matyas1995/home-thermosthat/thermostat/README

Errata: gate resistors on GPIO LED drivers missing. Will not pose great problems as long as switching frequency does not get too high to overload MCU pins.
