matyas1995/home-thermosthat/frdm_board/FRDM-KW41Z_C2-DESIGNFILES/GRB-29102/ReadMe.txt

README for GRB-29102_C1.zip

Company Part Number: 170-29102 REV C1

Date: Fri, 13 Oct 2017 03:05:51 GMT

NXP Semiconductors
6501 William Cannon Drive West
Austin, TX 78735-8598

CAD Engineer
============
Company Contact     : [full_name]
Work Phone          : 512-895-XXXX
Email               : [email]@nxp.com

CAD Manager
===========
Company Contact     : Daniel Kruczek
Work Phone          : 512-895-6081
Email               : daniel.kruczek@nxp.com

Manufacturing Program Manager
=============================
Company Contact     : [full_name]
Work Phone          : 512-895-XXXX
Email               : [email]@nxp.com

Product Engineer
================
Company Contact     : [full_name]
Work Phone          : 512-895-XXXX
Email               : [email]@nxp.com

Design for Manufacturing Engineer
=================================
Company Contact     : Andres Marquez
Work Phone          : +52(33) 3283-2100 x3068
Email               : andres.marquez@nxp.com
