matyas1995/home-thermosthat/tempsensor/Mouser_BOM.xls

Mfr Part Number (Input) | Manufacturer Part Number | Mouser Part Number | Manufacturer Name | Description | Quantity 1 | Unit Price 1 | Quantity 2 | Unit Price 2 | Quantity 3 | Unit Price 3 | Quantity 4 | Unit Price 4 | Quantity 5 | Unit Price 5 | Order Quantity | Order Unit Price | Min./Mult. | Availability | Lead Time in Days | Lifecycle | NCNR | RoHS | Pb Free | Package Type | Datasheet URL | Product Image | Design Risk
 | 04025A100JAT2A | 581-04025A100J | AVX | CAP CER 10PF 50V 5% C0G 0402 | 2
 | GRM155R71H104KE14D | GRM155R71H104KE14D | MURATA | CAP CER 0.1uF 50V 10% X7R 0402 | 10
 | EMK107BBJ106MA-T | 963-EMK107BBJ106MA-T | TAIO YUDEN | CAP CER 10uF 16V 20% X5R 0603 | 3
 | CC0402BRNPO9BNR70 | 603-CC402BRNPO9BNR70 | YAGEO | CAP CER 0.7pF 50V 0.1pF C0G 0402 | 1
 | GRM155R61E105KA12 | 81-GRM155R61E105KA2 | MURATA | CAP CER 1uF 25V 10% X5R 0402 | 5
 | 04023C103KAT2A | 581-04023C103KAT2A | AVX | CAP CER 0,01uF 50V 10% X7R 0402 | 2
 | GCM1555C1H120JA16 | 81-GCM1555C1H120JA6 | MURATA | CAP CER 12PF 50V 5% C0G 0402 | 2
 | M50-3600542R | 855-M50-3600542R | HARWIN | Cortex Debug Connector, standard ARM Cortex-M SWD and JTAG interface | 1
 | ANT-2.4-LCW-RPS | 712-ANT-2.4-LCW-RPS | LINX |  | 1
 | 63012242124506 | 710-63012242124506 | WUERTH | coaxial connector (BNC, SMA, SMB, SMC, Cinch/RCA, ...) | 1
 | VLS3012CX-100M-1 | 810-VLS3012CX-100M-1 | TDK | IND WW FER 10uH@1MHz 1.12A 20% 3012 | 1
 | LQP15MN5N6B02D | 81-LQP15MN5N6B02D | MURATA | IND -- 5.6nH@500MHz 140mA 1.78% 0402 | 1
 | LQW15ANR10J00D | 81-LQW15ANR10J00D | MURATA | IND -- 0.1uH@100MHZ 120MA 5% 0402 | 2
 | CRCW04021K80FKED | 71-CRCW0402-1.8K-E3 | VISHAY | Resistor | 1
 | MKW41Z512VHT4 | 841-MKW41Z512VHT4 | NXP | Kinetis KW41Z-2.4 GHz, Arm Cortex-M0+, 512kB Flash, 128kB SRAM, Multi Mode: Bluetooth LE and 802.15.4 Wireless Radio and generic FSK, LQFN-48 | 1
 | MCP9844T-BE/MNY | 579-MCP9844T-BE/MNY | MICROCHIP | ±1°C Accurate, 1.8V Digital Temperature Sensor, I²C, DFN-8 | 1
 | BQ24012DRCR | 595-BQ24012DRCR | TEXAS INSTRUMENTS | Single-Chip Li-Ion Charge Management IC, DFN-10 | 1
 | FA-128 32.0000MF20X-K3 | 732-FA128-32F20X-K3 | EPSON | Four pin crystal, GND on pins 2 and 4 | 1
 | FC-135 32.7680KA-AG | 732-FC135-32.76KAAG | EPSON | Two pin crystal | 1
