matyas1995/home-thermosthat/thermostat/Mouser_BOM.xls

Mfr Part Number (Input) | Manufacturer Part Number | Mouser Part Number | Manufacturer Name | Description | Quantity 1 | Unit Price 1 | Quantity 2 | Unit Price 2 | Quantity 3 | Unit Price 3 | Quantity 4 | Unit Price 4 | Quantity 5 | Unit Price 5 | Order Quantity | Order Unit Price | Min./Mult. | Availability | Lead Time in Days | Lifecycle | NCNR | RoHS | Pb Free | Package Type | Datasheet URL | Product Image | Design Risk
 | 3002 | 534-3002 | KEYSTONE | Coin Cell Holder, SMD | 1
 | GRM155R71H104KE14D | GRM155R71H104KE14D | MURATA | CAP CER 0.1uF 50V 10% X7R 0402 | 9
 | EMK107BBJ106MA-T | 963-EMK107BBJ106MA-T | TAIO YUDEN | CAP CER 10uF 16V 20% X5R 0603 | 7
 | GRM155R61E105KA12 | 81-GRM155R61E105KA2 | MURATA | CAP CER 1uF 25V 10% X5R 0402 | 9
 | 04025A100JAT2A | 581-04025A100J | AVX | CAP CER 10PF 50V 5% C0G 0402 | 2
 | GCM1555C1H120JA16 | 81-GCM1555C1H120JA6 | MURATA | CAP CER 12PF 50V 5% C0G 0402 | 2
 | CC0402BRNPO9BNR70 | 603-CC402BRNPO9BNR70 | YAGEO | CAP CER 0.7pF 50V 0.1pF C0G 0402 | 1
 | CL10C050BB8NNNC | 187-CL10C050BB8NNNC | SAMSUNG | CAP CER 5pF 50V 0.1pF C0G 0603 | 2
 | CC0603KRX5R8BB475 | 603-CC0603KRX58BB475 | YAGEO | CAP CER 4,7uF 25V 10% X5R 0603 | 1
 | 865080643008 | 710-865080643008 | WUERTH | CAP POL 22uF 50V 20% | 1
 | EEE-FN1C221XL | 667-EEE-FN1C221XL | PANASONIC | CAP POL 220uF 16V 20% | 1
 | 04023C103KAT2A | 581-04023C103KAT2A | AVX | CAP CER 0,01uF 50V 10% X7R 0402 | 8
 | 63012242124506 | 710-63012242124506 | WUERTH | coaxial connector (BNC, SMA, SMB, SMC, Cinch/RCA, ...) | 1
 | ANT-2.4-LCW-RPS | 712-ANT-2.4-LCW-RPS | LINX | coax antenna | 1
 | SFV24R-4STE1HLF | 649-SFV24R-4STE1HLF | AMPHENOL | Generic connector, single row, 01x24, script generated (kicad-library-utils/schlib/autogen/connector/) | 1
 | M50-3600542R | 855-M50-3600542R | HARWIN | Cortex Debug Connector, standard ARM Cortex-M SWD and JTAG interface | 1
 | 61032021121 | 710-61032021121 | WUERTH | Generic connector, single row, 01x20, script generated (kicad-library-utils/schlib/autogen/connector/) | 1
 | 61000421121 | 710-61000421121 | WUERTH | Generic connector, double row, 02x02, odd/even pin numbering scheme (row 1 odd numbers, row 2 even numbers), script generated (kicad-library-utils/schlib/autogen/connector/) | 1
 | LQW15ANR10J00D | 81-LQW15ANR10J00D | MURATA | IND -- 0.1uH@100MHZ 120MA 5% 0402 | 4
 | LQP15MN5N6B02D | 81-LQP15MN5N6B02D | MURATA | IND -- 5.6nH@500MHz 140mA 1.78% 0402 | 1
 | LBC3225T680KR | 963-LBC3225T680KR | TAIO YUDEN | Inductor | 1
 | 45334C | 580-45334C | MURATA | Inductor with iron core | 1
 | RL0603JR-070R47L | 603-RL0603JR070R47L | YAGEO | Resistor | 1
 | MKW41Z512VHT4 | 841-MKW41Z512VHT4 | NXP | Kinetis KW41Z-2.4 GHz, Arm Cortex-M0+, 512kB Flash, 128kB SRAM, Multi Mode: Bluetooth LE and 802.15.4 Wireless Radio and generic FSK, LQFN-48 | 1
 | MCP7940NT-I/MS | 579-MCP7940NT-I/MS | MICROCHIP | Real-Time Clock, I2C, Battery Backup, MSOP-8 | 1
 | MCP9844T-BE/MNY | 579-MCP9844T-BE/MNY | MICROCHIP | ±1°C Accurate, 1.8V Digital Temperature Sensor, I²C, DFN-8 | 1
 | LM2574HVM-5.0/NOPB | 926-LM2574HVM5.0NOPB | TEXAS INSTRUMENTS | 5V, 0.5A SIMPLE SWITCHER® Step-Down Voltage Regulator, SO-8 | 1
 | FA-128 32.0000MF20X-K3 | 732-FA128-32F20X-K3 | EPSON | Four pin crystal, GND on pins 2 and 4 | 1
 | FC-135 32.7680KA-AG | 732-FC135-32.76KAAG | EPSON | Two pin crystal | 2
