matyas1995/home-thermosthat/frdm_board/FRDM-KW41Z_C2-DESIGNFILES/BOM-29102_C2.xlsx

FRDM-KW41Z Revised: Monday, November 06, 2017
SCH-29102 PDF: SPF-29102 Revision: C2
Freescale Semiconductor
6501 William Cannon Drive West
Austin, TX 78735-8598
Bill Of Materials November 14,2018 11:08:09 | Page1
Item | Quantity | AgilePN | ASSY_OPT | Reference | Value | Description | ASSY_NOTE | Mfg Name | Mfg Part Number | PCB Footprint
______________________________________________
1 | 1 | 510-75678 |  | ANT1 | F_Antenna | PCB F ANTENNA, NO PART ORDER |  | NOT A PART | NOT A PART | f_antenna_dig528-2
2 | 1 | 801-76130 |  | BT500 | 3003 | HOLDER BATTERY 20MM DIA TH |  | Keystone Electronics | 3003 | batt_21x20mm
3 | 3 | 150-76334 |  | C1,C2,C9 | 1000pF | CAP CER 1000PF 50V 5% C0G 0402 |  | MURATA | GRM1555C1H102JA01D | CC0402_25
4 | 9 | 150-79092 |  | C3,C19,C25,C27,C28,C30,C43,C66,C75 | 10uF | CAP CER 10uF 16V 20% X5R 0603 |  | TAIYO YUDEN | EMK107BBJ106MA-T | CC0603_OV
5 | 1 | 150-79793 |  | C4 | 0.7pF | CAP CER 0.7pF 50V 0.1pF C0G 0402 |  | MURATA | GRM1555C1HR70BA01D | CC0402_25
6 | 26 | 150-79069 |  | C6,C11,C17,C18,C20,C21,C22,C24,C26,C31,C44,C57,C58,C59,C60,C61,C62,C63,C64,C65,C68,C69,C70,C74,C76,C79 | 0.1uF | CAP CER 0.1uF 50V 10% X7R 0402 |  | MURATA | GRM155R71H104KE14D | CC0402_25
7 | 2 | 150-75265 | DNP | C7,C72 | 10PF | CAP CER 10PF 50V 5% C0G 0402 |  | AVX | 04025A100JAT2A | CC0402_25
8 | 2 | 150-75265 |  | C8,C71 | 10PF | CAP CER 10PF 50V 5% C0G 0402 |  | AVX | 04025A100JAT2A | CC0402_25
9 | 2 | 150-75266 | DNP | C10,C15 | 22PF | CAP CER 22PF 50V 5% C0G 0402 |  | AVX | 04025A220JAT2A | CC0402_25
10 | 1 | 150-79735 | DNP | C12 | 0.7pF | CAP CER 0.7pF 50V 0.05pF C0G 0402 |  | NIC COMPONENTS CORP | NMC-Q0402NPO0R7A50TRPF | CC0402_25
11 | 1 | 150-75116 | DNP | C13 | 18PF | CAP CER 18PF 50V 5% C0G 0603 |  | YAGEO AMERICA | CC0603JRNPO9BN180 | CC0603_OV
12 | 2 | 150-75680 |  | C14,C77 | 12PF | CAP CER 12PF 50V 5% C0G 0402 |  | NIC COMPONENTS CORP | NMC0402NPO120J50TRPF | CC0402_25
13 | 4 | 150-79795 |  | C23,C29,C67,C78 | 1uF | CAP CER 1UF 50V 10% X5R 0603 |  | MURATA | GRM188R61H105KAALD | CC0603_OV
14 | 2 | 150-30297 |  | C32,C33 | 220PF | CAP CER 220PF 50V 5% C0G 0402 |  | KEMET | C0402C221J5GAC | CC0402_25
15 | 1 | 150-78463 |  | C41 | 4.7uF | CAP CER 4.7UF 6.3V 20% X5R 0402 |  | TDK | C1005X5R0J475M050BC | CC0402_25
16 | 2 | 150-75417 |  | C48,C56 | 2.2uF | CAP CER 2.2UF 16V 10% X5R 0603 |  | MURATA | GRM188R61C225KE15D | CC0603_OV
17 | 3 | 150-79069 | DNP | C49,C81,C82 | 0.1uF | CAP CER 0.1uF 50V 10% X7R 0402 |  | MURATA | GRM155R71H104KE14D | CC0402_25
18 | 4 | 150-79092 | DNP | C50,C51,C52,C53 | 10uF | CAP CER 10uF 16V 20% X5R 0603 |  | TAIYO YUDEN | EMK107BBJ106MA-T | CC0603_OV
19 | 1 | 150-80001 |  | C80 | 1uF | CAP CER 1uF 25V 10% X5R 0402 |  | MURATA | GRM155R61E105KA12 | CC0402_25
20 | 5 | 150-80053 |  | C83,C84,C85,C86,C87 | 3.0PF | CAP CER 3.0PF 50V 3.3% C0G 0402 |  | MURATA | GRM1555C1H3R0BA01D | CC0402_25
21 | 2 | 370-76693 |  | LED2,D2 | YEL-GRN | LED SUPER YEL/GRN SGL 25MA SMD 0603 |  | EVERLIGHT INTERNATIONAL CORPORATION | 19-213SYGC/S454/TR8 | LED_0603
22 | 8 | 480-79681 |  | D3,D4,D5,D6,D7,D8,D9,D10 | RB160M-30 | DIODE SCH 1A 30V SOD123 |  | ROHM | RB160M-30TR | pmdu_sod123
23 | 1 | 370-76645 | DNP | D11 | VSMB2948SL | LED IR RA 100mA 1.35V 940NM SMD |  | VISHAY INTERTECHNOLOGY | VSMB2948SL | led_ra_2p5x2p75_sm
24 | 2 | 210-81494 |  | J1,J3 | SKT_1X8 | CON 1X8 SKT TH 100MIL SP 343H AU 126L |  | LIANYI DIANZI | 218108S1411 | con_1x8_skt_2p54_th
25 | 1 | 210-81493 |  | J2 | SKT_1X10 | CON 1X10 SKT TH 100MIL SP 343H AU 126L |  | LIANYI DIANZI | 218110S1411 | con_skt1x10_th
26 | 1 | 210-81495 |  | J4 | SKT_1X6 | CON 1X6 SKT TH 100MIL SP 343H AU 126L |  | LIANYI DIANZI | 218106S1411 | con_skt1x6_th
27 | 1 | 211-79911 |  | J5 | SLE-100010072-F01 | CON 1 JACK SMA SKT 50 OHM SMT -- 418H AU |  | Dongguan Senling Industrial Co. Ltd | SLE-100010072-F01 | con5_sma_7sq_sm
28 | 1 | 211-78945 |  | J6 | USB_MICRO_AB | CON 5 USB_MICRO_AB_RECEPTACLE RA SKT SMT 0.65MM SP 122H AU |  | molex | 475900001 | con_microab_10f_25_sm_ra
29 | 7 | 210-81145 |  | J8,J19,J20,J21,J23,J34,J35 | HDR_1X2 | HDR 1X2 TH 100MIL SP 347H AU 118L |  | LIANYI DIANZI | 313102S1411 | hdr_1x2_2p54mm
30 | 2 | 210-81148 |  | J9,J11 | HDR 2X5 | HDR 2X5 TH 50MIL CTR 264H AU 91L |  | LIANYI DIANZI | 333210S1411 | hdr_2X5_6x3_1p27mm_th
31 | 10 | 210-75439 | DNP | J12,J13,J14,J22,J25,J28,J29,J30,J31,J37 | HDR 1X2 TH | HDR 1X2 TH 100MIL SP 339H AU 98L |  | SAMTEC | TSW-102-07-G-S | SH_HDR102_BOTTOM
32 | 2 | 210-81149 | DNP | J16,J17 | HDR 2X3 | HDR 2X3 TH 100MIL CTR 350H AU 118L |  | LIANYI DIANZI | 313206S1411 | hdr203_m20
33 | 2 | 210-75442 |  | J18,J24 | HDR_1X3 | HDR 1X3 TH 100MIL SP 330H AU 98L |  | SAMTEC | HTSW-103-07-S-S | HDR103
34 | 1 | 210-75442 | DNP | J26 | HDR_1X3 | HDR 1X3 TH 100MIL SP 330H AU 98L |  | SAMTEC | HTSW-103-07-S-S | HDR103
35 | 1 | 210-81149 |  | J36 | HDR 2X3 | HDR 2X3 TH 100MIL CTR 350H AU 118L |  | LIANYI DIANZI | 313206S1411 | hdr203_m20
36 | 2 | 210-81145 | DNP | J38,J39 | HDR_1X2 | HDR 1X2 TH 100MIL SP 347H AU 118L |  | LIANYI DIANZI | 313102S1411 | hdr_1x2_2p54mm
37 | 1 | 370-76692 |  | LED1 | RED | LED ULTRA BRIGHT RED SGL 25MA SMT 0603 |  | EVERLIGHT INTERNATIONAL CORPORATION | 19-213/R6C-AP1Q2B/3T | led_0603
38 | 1 | 370-76689 |  | LED3 | RED | LED RED CLEAR SGL 25MA SMT 0805 |  | EVERLIGHT INTERNATIONAL CORPORATION | 17-21SURC/S530-A2/TR8 | led_2p_0805
39 | 1 | 370-76567 |  | LED4 | CLV1A-FKB-CJ1M1F1BB7R4S3 | LED RED BL GRN SGL 50/25/25mA SMT |  | CREE, INC | CLV1A-FKB-CJ1M1F1BB7R4S3 | led4_3p4x3mm_smt
40 | 1 | 180-78707 |  | L1 | 5.6nH | IND -- 5.6nH@500MHz 140mA 1.78% 0402 |  | MURATA | LQP15MN5N6B02 | IND_0402
41 | 2 | 180-78474 |  | L2,L4 | 330 OHM@100MHZ | IND FER BEAD 330 OHM@100MHZ 1.2A 25% 0603 |  | MURATA | BLM18PG331SN1 | IND_0603
42 | 1 | 180-78215 |  | L3 | 10uH | IND WW FER 10uH@1MHz 0.99A 20% 4012 |  | TDK | VLS4012ET-100M | ind_vls4012e
43 | 2 | 180-78473 |  | L5,L6 | 0.1uH | IND -- 0.1uH@100MHZ 120MA 5% 0402 |  | MURATA | LQW15ANR10J00D | IND_0402
44 | 4 | 480-79704 |  | Q1,Q5,Q6,Q7 | BSH111BK | TRAN NMOS SW FET 55V 210mA SOT23 |  | NEXPERIA | BSH111BKR | SOT23_A
45 | 1 | 480-75173 | DNP | Q2 | MMBT3904LT1G | TRAN NPN GEN 200MA 40V SOT-23 |  | NEXPERIA | MMBT3904,215 | SOT23_A
46 | 1 | 470-80022 |  | RT2 | 10K | THERMISTOR 10K 1/10W 1% 0603 |  | MuRata | NCP18XH103F03RB | RC0603_OV
47 | 3 | 470-30454 |  | R1,R2,R6 | 100 | RES MF 100 OHM 1/16W 1% 0402 |  | THYE MING TECH CO LTD | CR-02FL6--100R | RC0402_25
48 | 13 | 470-75394 | DNP | R3,R7,R12,R14,R32,R51,R73,R75,R92,R96,R676,R677,R678 | 0 | RES MF ZERO OHM 1/16W 5% 0402 |  | ROHM | MCR01MZPJ000 | RC0402_25
49 | 2 | 470-81149 |  | R8,R9 | 4.99K | RES MF 4.99K 1/16W 1% 0402 |  | YAGEO AMERICA | RC0402FR-074K99L | RC0402_25
50 | 3 | 470-30297 |  | R10,R57,R81 | 220 | RES MF 220 OHM 1/10W 5% 0603 |  | YAGEO AMERICA | RC0603JR-07220RL | RC0603_OV
51 | 17 | 470-80452 |  | R11,R13,R15,R20,R23,R33,R34,R38,R47,R60,R63,R65,R93,R652,R653,R654,R675 | 10K | RES MF 10K 1/16W 1% 0402 |  | yageo | RC0402FR-1310KL | RC0402_25
52 | 8 | 470-80452 | DNP | R16,R17,R24,R26,R40,R69,R70,R95 | 10K | RES MF 10K 1/16W 1% 0402 |  | yageo | RC0402FR-1310KL | RC0402_25
53 | 21 | 470-75394 |  | R18,R22,R29,R30,R31,R35,R37,R39,R42,R61,R66,R74,R77,R79,R80,R82,R83,R84,R86,R89,R97 | 0 | RES MF ZERO OHM 1/16W 5% 0402 |  | ROHM | MCR01MZPJ000 | RC0402_25
54 | 5 | 470-75626 |  | R19,R46,R59,R64,R91 | 4.7K | RES MF 4.7K 1/16W 5% 0402 |  | NIC COMPONENTS CORP | NRCL04J472TRF | RC0402_25
55 | 2 | 470-75790 |  | R21,R25 | 33 | RES MF 33.0 OHM 1/16W 1% 0402 |  | THYE MING TECH CO LTD | CR-02FL6---33R | RC0402_25
56 | 3 | 470-75555 |  | R27,R28,R41 | 1K | RES MF 1.0K 1/16W 5% 0402 |  | VISHAY INTERTECHNOLOGY | CRCW04021K00JNED | RC0402_25
57 | 1 | 470-76066 |  | R44 | 15K | RES MF 15.0K 1/16W 1% 0402 |  | NIC COMPONENTS CORP | NRCL04F1502TRF | RC0402_25
58 | 4 | 470-80866 |  | R45,R54,R87,R88 | 0 | RES MF ZERO OHM 1/10W -- 0603 |  | BOURNS | CR0603J/000ELF | RC0603_OV
59 | 1 | 470-81193 |  | R52 | 18.2 | RES MF 18.2 OHM 1/8W 1% 0805 |  | YAGEO AMERICA | RC0805FR-0718R2L | RC0805_OV
60 | 1 | 470-76303 |  | R55 | 1.5K | RES MF 1.5K 1/16W 5% 0402 |  | VISHAY INTERTECHNOLOGY | CRCW04021K50JNED | RC0402_25
61 | 1 | 470-81164 |  | R56 | 27K | RES MF 27K 1/16W 1% 0402 |  | YAGEO AMERICA | RC0402FR-0727KL | RC0402_25
62 | 2 | 470-76602 |  | R62,R67 | 2.2K | RES MF 2.2K 1/16W 5% 0402 |  | YAGEO AMERICA | RC0402JR-072K2L | RC0402_25
63 | 1 | 470-81192 |  | R85 | 102K | RES MF 102K 1/16W 1% HF 0402 |  | YAGEO AMERICA | RC0402FR-07102KL | RC0402_25
64 | 1 | 470-81163 | DNP | R90 | 180K | RES MF 180K 1/16W 1% 0402 |  | YAGEO AMERICA | RC0402FR-07180KL | RC0402_25
65 | 1 | 470-75626 | DNP | R94 | 4.7K | RES MF 4.7K 1/16W 5% 0402 |  | NIC COMPONENTS CORP | NRCL04J472TRF | RC0402_25
66 | 2 | 470-30782 |  | R670,R671 | 270 | RES MF 270 OHM 1/10W 1% AEC-Q200 0402 |  | KOA SPEER | RK73H1ETTP2700F | RC0402_25
67 | 1 | 470-30801 |  | R672 | 430 | RES MF 430 OHM 1/10W 1% AEC-Q200 0402 |  | KOA SPEER | RK73H1ETTP4300F | RC0402_25
68 | 15 | 470-76449 |  | SH3,SH4,SH7,SH8,SH9,SH10,SH11,SH12,SH13,SH14,SH15,SH25,SH28,SH29,SH30 | 0 | ZERO OHM CUT TRACE 0402 PADS; NO PART TO ORDER |  | LAYOUT ELEMENT ONLY | LAYOUT ELEMENT ONLY | SH0402
69 | 3 | 470-80018 |  | SH500,SH501,SH503 | 0 | ZERO OHM CUT TRACE 0603 PADS; NO PART TO ORDER |  | LAYOUT ELEMENT ONLY | LAYOUT ELEMENT ONLY | SH0603
70 | 4 | 510-78063 |  | SW1,SW3,SW4,SW6 | KAN0444-0201E1 | SW SPST TACT PB 50MA 12V SMT |  | WENZHOU GANGYUAN ELECTRONICS CO., LTD. | KAN0444-0201E1 | sw2_tact_4x3_sm
71 | 2 | 510-77018 |  | SW2,SW5 | 3x3mm | CAPACITIVE SINGLE ELECTRODE 3X3MM SQUARED ROUNDED CORNERS (NOT A PART TO ORDER) |  | Freescale | Single Electrode 3MM x 3MM | electrode_sq_3mm
72 | 1 | 210-79450 |  | TP1 | TESTLOOP_BLACK | TEST POINT PC MULTI PURPOSE BLK TH |  | KEYSTONE ELECTRONICS | 5011 | tp_th_063
73 | 35 | 211-76642 |  | TP2,TP6,TP7,TP8,TP14,TP17,TP18,TP19,TP20,TP21,TP22,TP24,TP25,TP26,TP27,TP28,TP29,TP30,TP31,TP32,TP33,TP34,TP41,TP42,TP45,TP47,TP48,TP50,TP51,TP52,TP53,TP54,TP55,TP56,TP58 | TPAD_030 | TEST POINT PAD 30MIL DIA SMT, NO PART TO ORDER |  | NOTACOMPONENT | NOTACOMPONENT | TPAD_030
74 | 19 | 211-76643 |  | TP3,TP4,TP9,TP10,TP11,TP12,TP15,TP16,TP23,TP35,TP36,TP37,TP38,TP39,TP40,TP43,TP44,TP46,TP57 | TPAD_040 | TEST POINT PAD 40MIL DIA SMT, NO PART TO ORDER |  | NOTACOMPONENT | NOTACOMPONENT | TPAD_040
75 | 2 | 480-78091 | DNP | TVS1,TVS2 | PGB2010402KRHF | DIODE ESD SUPPRESSOR BIDIR -- 12V 0402 |  | LITTELFUSE | PGB2010402KRHF | diode_0402
76 | 1 | 344-02171 |  | U1 | MKW41Z512VHT4 | IC MCU XCVR 2.4GHZ 1.71-3.6V MAPLGA48 |  | NXP SEMICONDUCTORS | MKW41Z512VHT4 | maplga48_7x7_0p5mm
77 | 3 | 480-76179 |  | U2,U3,U6 | 0402ESDA-MLP | DIODE TVS BIDIR -- 30V 0402 |  | COOPER BUSSMANN | 0402ESDA-MLP1 | 0402_mlp
78 | 1 | 342-00652 |  | U4 | AT45DB041E | IC MEM DATA FLASH 4MBIT SPI 85MHZ 1.65-3.6V UDFN8 |  | Adesto Technologies Corporation, Inc | AT45DB041E-MHN-Y | dfn8_1p27_6x5mm_3p6x4p2
79 | 3 | 312-80758 |  | U5,U15,U16 | 74LVCH1T45 | IC XCVR 1BIT 3-STATE DUAL 1.2-5.5V XSON6 |  | NEXPERIA | 74LVCH1T45GM,132 | udfn6_1x1p5mm
80 | 1 | 344-01231 |  | U7 | MK20DX128VFM5 | IC MCU FLASH 128KB 50MHZ 1.71-3.6V QFN32 |  | FREESCALE SEMICONDUCTOR | MK20DX128VFM5 | QFN32_S142EP
81 | 1 | 312-80762 |  | U8 | 74LVC2T45GM,125 | IC XCVR DUAL SUPPLY 1.2 -5.5V XQFN8 |  | NEXPERIA | 74LVC2T45GM,125 | qfn8_1p6x1p6mm
82 | 1 | 312-80418 |  | U9 | FXOS8700CQ | IC ACCELEROMETER AND MAGNETOMETER SENSOR 3-AXIS 2.5V QFN16 |  | Freescale Semiconductor | FXOS8700CQ | QFN5X3_0P5_3X3
83 | 1 | 315-79199 |  | U10 | MIC2005-0.8YM6 | IC LIN SW PWR 0.8A 2.5-5.5V SOT23-6 |  | MICREL | MIC2005-0.8YM6 | SOT23-6_a
84 | 1 | 315-80556 |  | U11 | NLX2G14 | IC INV DUAL SCHMITT TRIGGER 1.65-5.5V UDFN6 |  | On Semiconductor | NLX2G14AMUTCG | udfn6_1p45x1_0p5mm
85 | 1 | 312-80039 |  | U17 | NCP1117ST33T3G | IC VREG LDO 1A 3.3V SOT223 |  | ON Semiconductor | NCP1117ST33T3G | sot223
86 | 1 | 312-80763 |  | U500 | NTSX2102GU8H | IC DUAL SUPPLY XCVR 50 MBPS 5.5V XQFN8 |  | NXP Semiconductors | NTSX2102GU8H | xqfn8_1p45x1p25mm
87 | 1 | 230-77664 |  | X1 | 8.00MHZ | XTAL 8.00MHZ RSN CERAMIC -- SMT |  | MURATA | CSTCE8M00G55-R0 | xtal3_3p35x1p45_sm
88 | 1 | 230-78107 |  | Y1 | 32MHZ | XTAL 32MHZ 10PPF 10PPM SMT |  | EPSON ELECTRONICS | Q22FA12800092 | xtal4_2p1x1p7mm_sm
89 | 1 | 230-78102 |  | Y2 | 32.768KHZ | XTAL 32.768KHZ 7PF 20PPM -- SMT |  | EPSON ELECTRONICS | FC-135 32.7680KA-AG3 | XTAL2-3p2x1p5-SM
