matyas1995/home-thermosthat/firmware/TODO.md

- OpenThread Task soll auf interruptgesteuert statt polling umgestellt werden. Hauptsächsich scheitert das an der UART receive Funktion, da der Teil, der den Interrupt bisher auslöst, selber auf diesen wartet. Der Task Loop hat der nötige Code schon drin, nur auskommentiert.
    - Das soll so erreicht werden, dass alles OpenThread spezifische inkl. der UART in dem OpenThread Prozess bleibt, auch die UART auslöse etc. Funktionen. In den IRQHandler der PIT, XVCR und UART muss der TaskNotifyGive rein, damit die den OpenThread Prozess wecken können.
- processTransmit() kann auch direkt ins UART IRQ, da dort die selbe Kondition eh geprüft wird.
- Create bash script to start JLinkExe (maybe it is useful)
- rewrite the linker script with the tutorial of memfault to clean up shit. Also fix the startup code to use C code instead of the unreadable assembly file.
- to support VLLS mode and be able to wake up without having to restart the mcu, look into the memory map and the SRAM map. The SRAM has sections that are not powered off during VLLS
- insert a stack canary word between stack and heap to detect stack or heap overflows. The checking can be done with FreeRTOS. Sadly the MCU has no MPU for this...
- for the ePaper driver, use the Raspberry Pi code. It is C and not C++ like in the Arduino exapmle.
    https://github.com/waveshare/e-Paper/tree/master/RaspberryPi_JetsonNano/c/lib
