matyas1995/home-thermosthat/frdm_board/FRDM-KW41Z_C2-DESIGNFILES/FAB-29102_C1.pdf

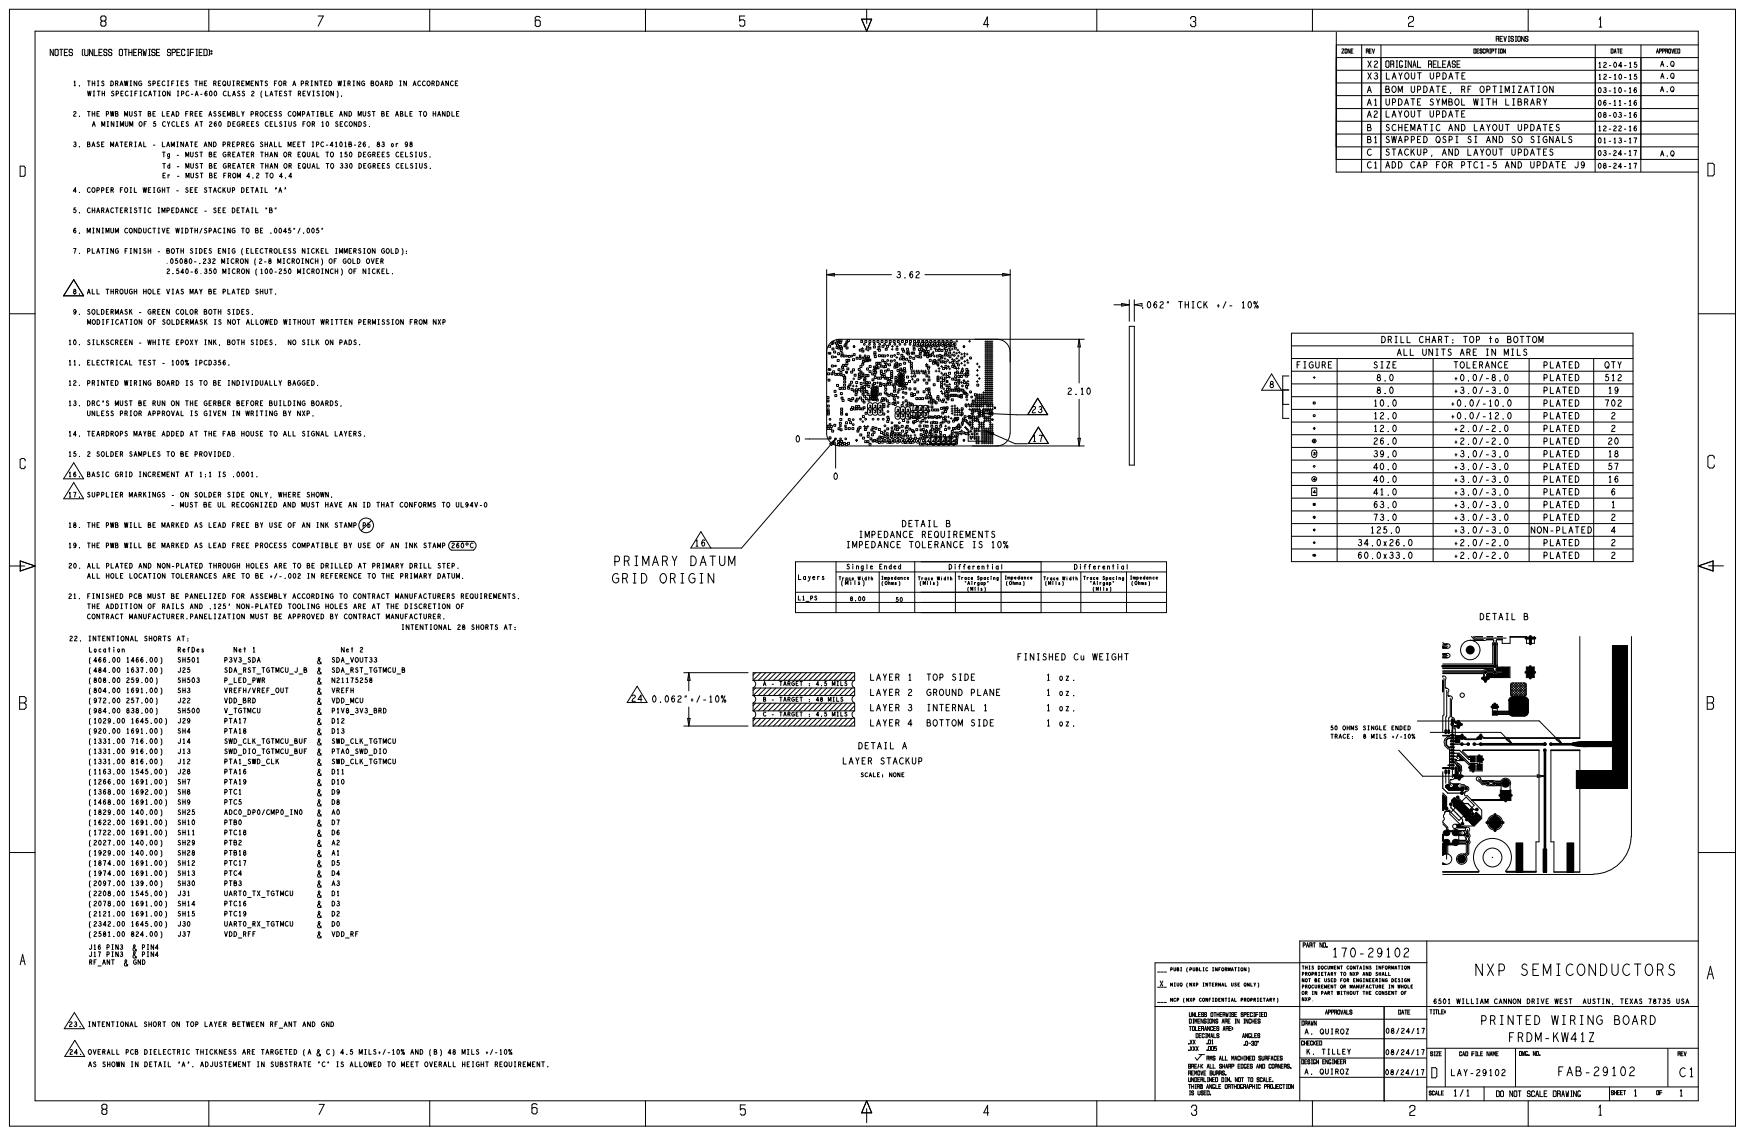
[picture p1: page 1]
