matyas1995/home-thermosthat/thermostat/home-thermostat.kicad_pcb

## KiCad design thermostat/home-thermostat.kicad_pcb (2021-06-10)

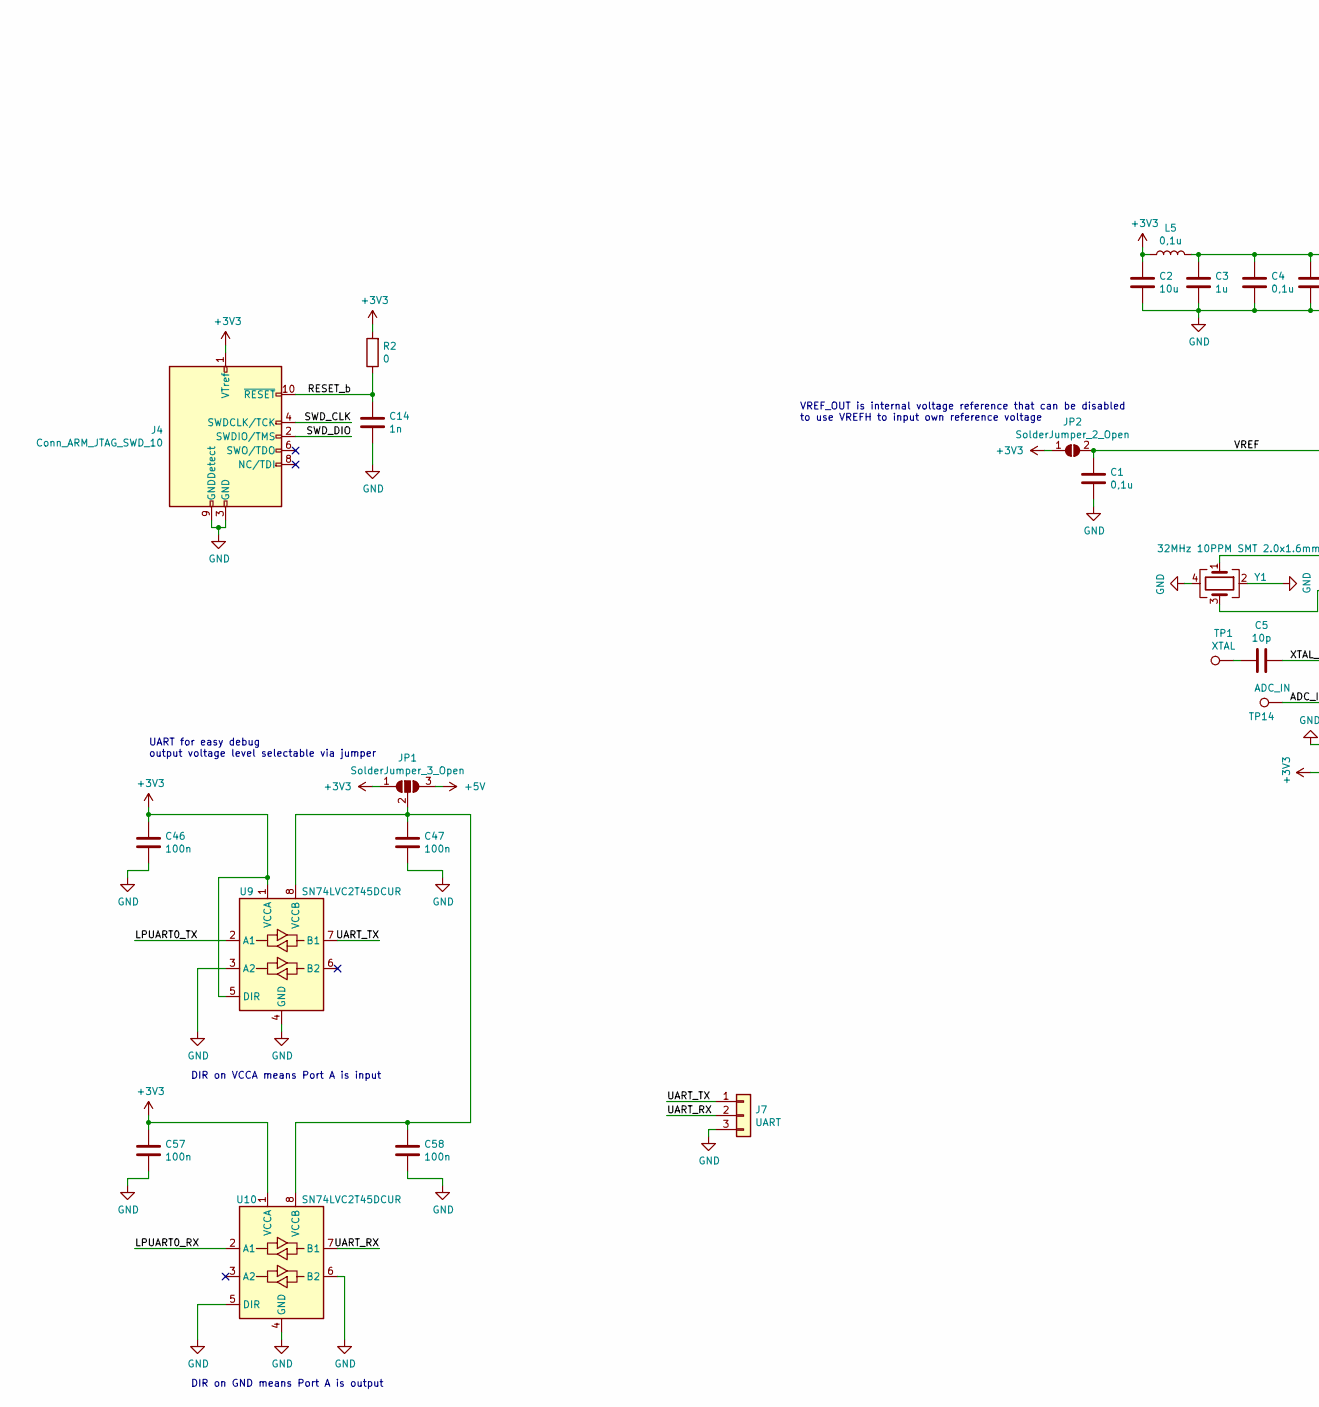
[picture p2: schematic home-thermostat.sch, part in row 1, column 1]

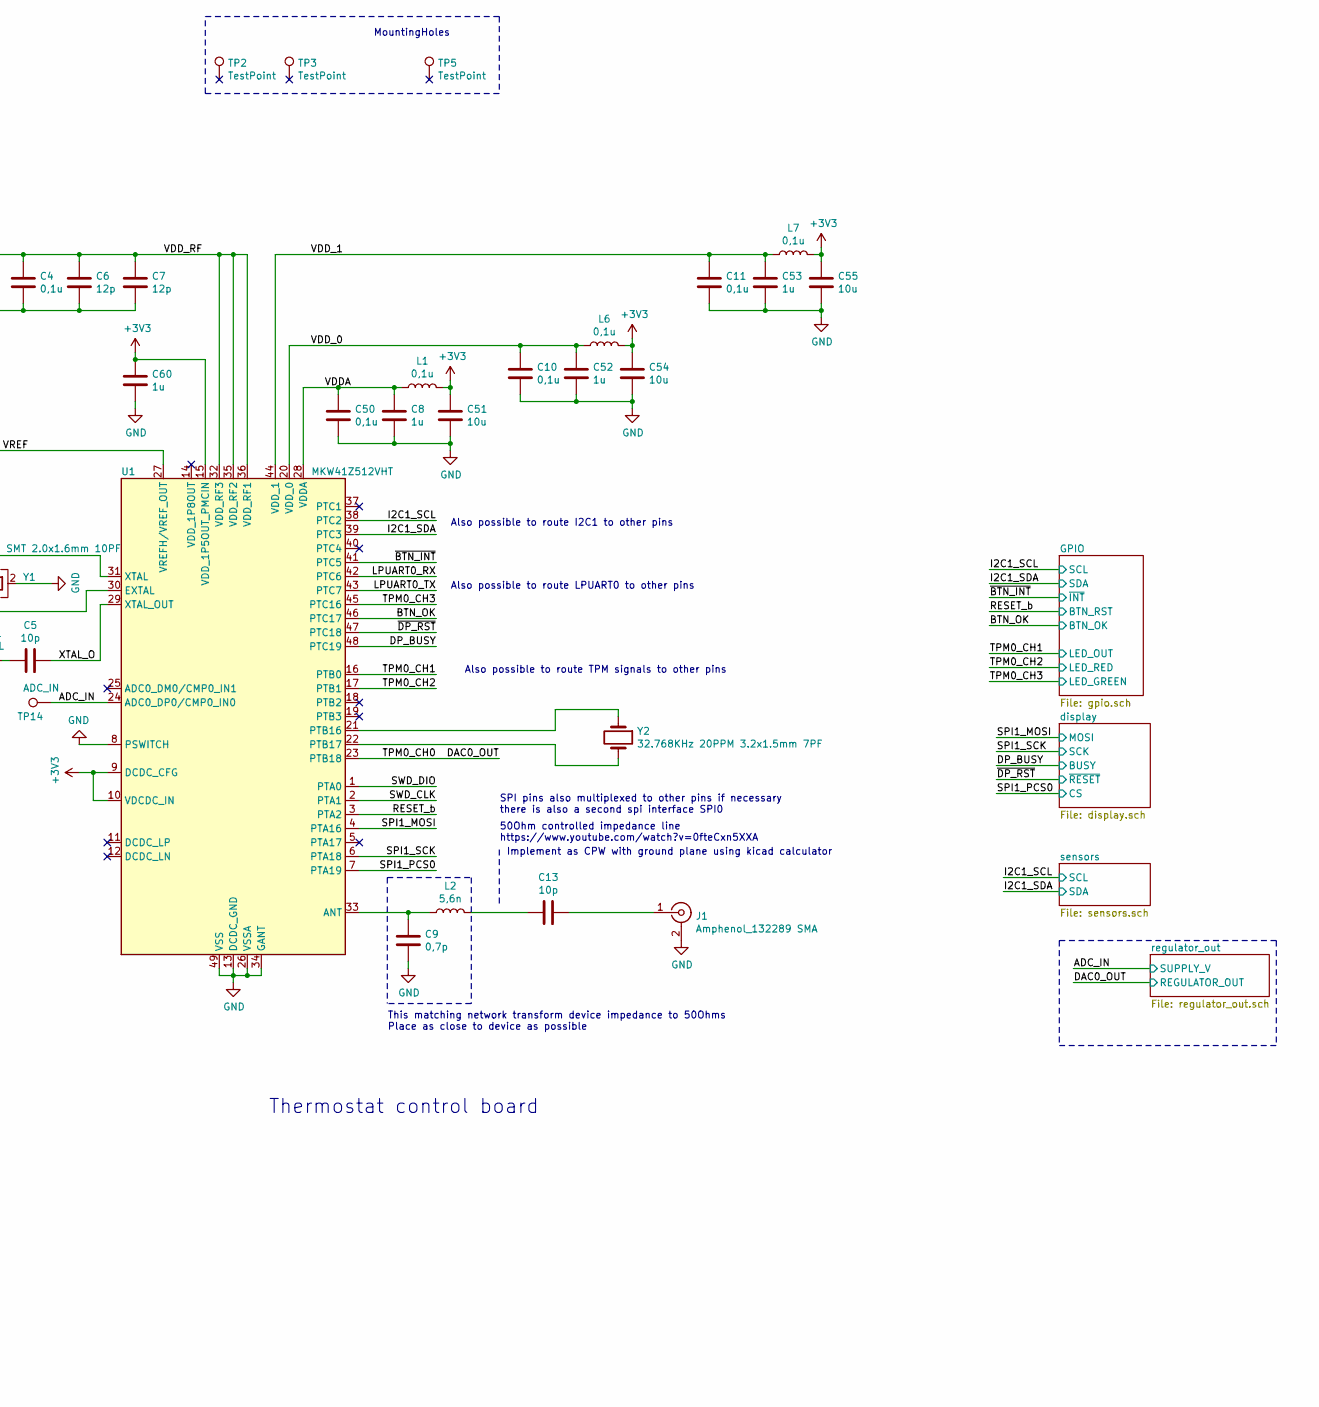
[picture p3: schematic home-thermostat.sch, part in row 1, column 2]

Parts:
C1, C4, C10, C11, C50: 0,1u; C_0402_1005Metric
C2, C51, C54, C55: 10u; C_0603_1608Metric
C3, C8, C52, C53, C60: 1u; C_0402_1005Metric
C5, C13: 10p; C_0402_1005Metric
C6, C7: 12p; C_0402_1005Metric
C9: 0,7p; C_0402_1005Metric
C14: 1n; C_0402_1005Metric
C46, C47, C57, C58: 100n; C_0603_1608Metric
J1: Amphenol_132289 SMA; SMA_Amphenol_132289_EdgeMount
J4: Conn_ARM_JTAG_SWD_10; PinHeader_2x05_P1.27mm_Vertical_SMD
J7: UART; PinHeader_1x03_P2.54mm_Vertical_SMD_Pin1Left
JP1: SolderJumper_3_Open; SolderJumper-3_P1.3mm_Open_Pad1.0x1.5mm
JP2: SolderJumper_2_Open; SolderJumper-2_P1.3mm_Open_Pad1.0x1.5mm
L1, L5, L6, L7: 0,1u; L_0402_1005Metric
L2: 5,6n; L_0402_1005Metric
R2: 0; R_0402_1005Metric
TP1: XTAL; TestPoint_Pad_D1.0mm
TP2, TP3, TP5: TestPoint; MountingHole_3.2mm_M3
TP14: ADC_IN; TestPoint_Pad_D1.0mm
U1: MKW41Z512VHT; NXP_LQFN-48-1EP_7x7mm_P0.5mm_EP3.5x3.5mm_16xMask0.45x0.45
U9, U10: SN74LVC2T45DCUR; VSSOP-8_3.0x3.0mm_P0.65mm
Y1: 32MHz 10PPM SMT 2.0x1.6mm 10PF; Crystal_SMD_2016-4Pin_2.0x1.6mm
Y2: 32.768KHz 20PPM 3.2x1.5mm 7PF; Crystal_SMD_3215-2Pin_3.2x1.5mm

Connections:
+3V3: C2.2, C46.1, C51.2, C54.2, C55.2, C57.1, C60.1, J4.1 (VTref), JP1.1 (A), JP2.1 (A), L1.2, L5.1, L6.2, L7.2, R2.2, U1.9 (DCDC_CFG), U1.10 (VDCDC_IN), U1.15 (VDD_1P5OUT_PMCIN), U9.1 (VCCA), U9.5 (DIR), U10.1 (VCCA); also elsewhere on the board
+5V: JP1.3 (B); also elsewhere on the board
/ADC_IN: TP14.1, U1.24 (ADC0_DP0/CMP0_IN0); also elsewhere on the board
/BTN_OK: U1.46 (PTC17); also elsewhere on the board
/DAC0_OUT: U1.23 (PTB18); also elsewhere on the board
/DP_BUSY: U1.48 (PTC19); also elsewhere on the board
/I2C1_SCL: U1.38 (PTC2); also elsewhere on the board
/I2C1_SDA: U1.39 (PTC3); also elsewhere on the board
/LPUART0_RX: U1.42 (PTC6), U10.2 (A1)
/LPUART0_TX: U1.43 (PTC7), U9.2 (A1)
/RESET_b: C14.1, J4.10 (~RESET~), R2.1, U1.3 (PTA2); also elsewhere on the board
/SPI1_MOSI: U1.4 (PTA16); also elsewhere on the board
/SPI1_PCS0: U1.7 (PTA19); also elsewhere on the board
/SPI1_SCK: U1.6 (PTA18); also elsewhere on the board
/SWD_CLK: J4.4 (SWDCLK/TCK), U1.2 (PTA1)
/SWD_DIO: J4.2 (SWDIO/TMS), U1.1 (PTA0)
/TPM0_CH1: U1.16 (PTB0); also elsewhere on the board
/TPM0_CH2: U1.17 (PTB1); also elsewhere on the board
/TPM0_CH3: U1.45 (PTC16); also elsewhere on the board
/UART_RX: J7.2, U10.7 (B1)
/UART_TX: J7.1, U9.7 (B1)
/VDDA: C8.1, C50.1, L1.1, U1.28 (VDDA)
/VDD_0: C10.1, C52.1, L6.1, U1.20 (VDD_0)
/VDD_1: C11.1, C53.1, L7.1, U1.44 (VDD_1)
/VDD_RF: C3.1, C4.1, C6.1, C7.1, L5.2, U1.32 (VDD_RF3), U1.35 (VDD_RF2), U1.36 (VDD_RF1)
/VREF: C1.1, JP2.2 (B), U1.27 (VREFH/VREF_OUT)
/XTAL_O: C5.1, U1.29 (XTAL_OUT)
/~BTN_INT: U1.41 (PTC5); also elsewhere on the board
/~DP_RST: U1.47 (PTC18); also elsewhere on the board
GND: C1.2, C2.1, C3.2, C4.2, C6.2, C7.2, C8.2, C9.2, C10.2, C11.2, C14.2, C46.2, C47.2, C50.2, C51.1, C52.2, C53.2, C54.1, C55.1, C57.2, C58.2, C60.2, J1.2 (Ext), J4.3 (GND), J4.5 (GND), J4.9 (GNDDetect), J7.3, U1.8 (PSWITCH), U1.13 (DCDC_GND), U1.26 (VSSA), U1.34 (GANT), U1.49 (VSS), U9.3 (A2), U9.4 (GND), U10.4 (GND), U10.5 (DIR), U10.6 (B2), Y1.2, Y1.4; also elsewhere on the board
unnamed: C5.2, TP1.1
unnamed: C9.1, L2.1, U1.33 (ANT)
unnamed: C13.1, J1.1 (In)
unnamed: C13.2, L2.2
unnamed: C47.1, C58.1, JP1.2 (C), U9.8 (VCCB), U10.8 (VCCB)
unnamed: U1.21 (PTB16), Y2.1
unnamed: U1.22 (PTB17), Y2.2
unnamed: U1.30 (EXTAL), Y1.3
unnamed: U1.31 (XTAL), Y1.1

Notes on the sheet:
Thermostat control board
50Ohm controlled impedance line https://www.youtube.com/watch?v=0fteCxn5XXA
Implement as CPW with ground plane using kicad calculator
This matching network transform device impedance to 50Ohms Place as close to device as possible
SPI pins also multiplexed to other pins if necessary there is also a second spi interface SPI0
Also possible to route I2C1 to other pins
Also possible to route LPUART0 to other pins
VREF_OUT is internal voltage reference that can be disabled to use VREFH to input own reference voltage
Also possible to route TPM signals to other pins
MountingHoles
DIR on VCCA means Port A is input
UART for easy debug output voltage level selectable via jumper
DIR on GND means Port A is output

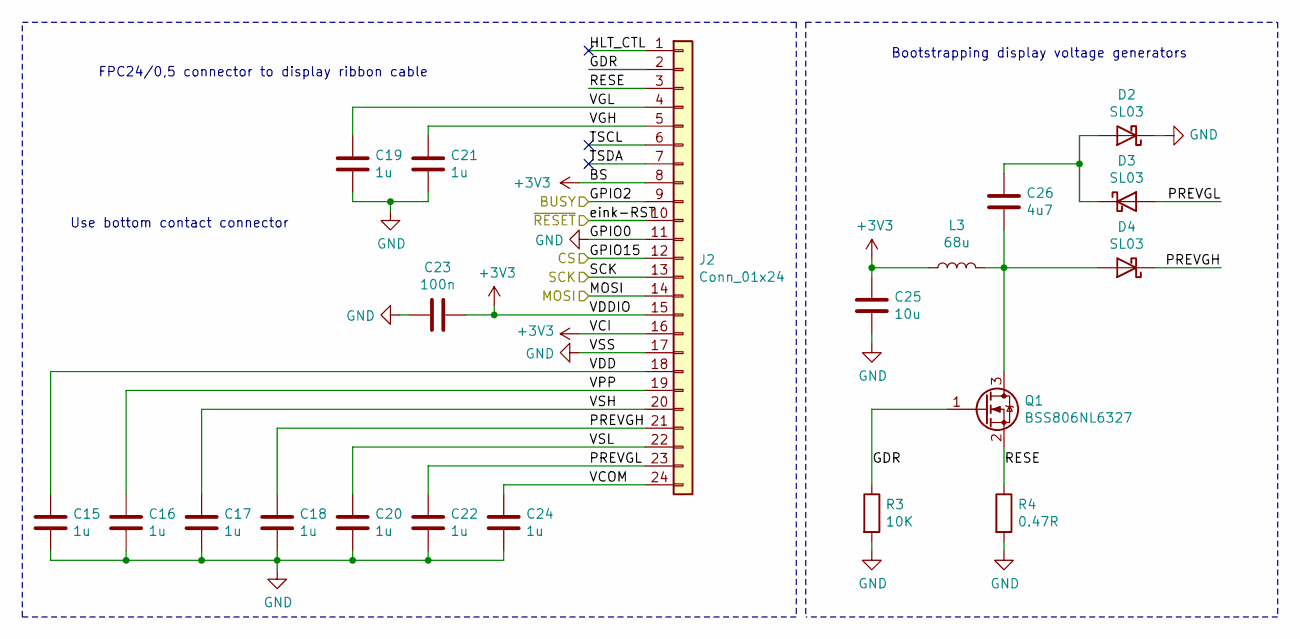
[picture p4: schematic display.sch]

Parts:
C15, C16, C17, C18, C19, C20, C21, C22, C24: 1u; C_0603_1608Metric
C23: 100n; C_0603_1608Metric
C25: 10u; C_0603_1608Metric
C26: 4u7; C_0603_1608Metric
D2, D3, D4: SL03; D_SMF
J2: Conn_01x24; TE_2-1734839-4_1x24-1MP_P0.5mm_Horizontal
L3: 68u; L_1210_3225Metric
Q1: BSS806NL6327; SOT-23
R3: 10K; R_0603_1608Metric
R4: 0.47R; R_0603_1608Metric

Connections:
+3V3: C23.2, C25.1, J2.8, J2.15, J2.16, L3.1; also elsewhere on the board
/DP_BUSY: J2.9; also elsewhere on the board
/SPI1_MOSI: J2.14; also elsewhere on the board
/SPI1_PCS0: J2.12; also elsewhere on the board
/SPI1_SCK: J2.13; also elsewhere on the board
/display/GDR: J2.2, Q1.1 (G), R3.1
/display/HLT_CTL: J2.1
/display/PREVGH: C18.1, D4.1 (K), J2.21
/display/PREVGL: C22.1, D3.2 (A), J2.23
/display/RESE: J2.3, Q1.2 (S), R4.1
/display/TSCL: J2.6
/display/TSDA: J2.7
/display/VCOM: C24.1, J2.24
/display/VDD: C15.1, J2.18
/display/VGH: C21.2, J2.5
/display/VGL: C19.2, J2.4
/display/VPP: C16.1, J2.19
/display/VSH: C17.1, J2.20
/display/VSL: C20.1, J2.22
/~DP_RST: J2.10; also elsewhere on the board
GND: C15.2, C16.2, C17.2, C18.2, C19.1, C20.2, C21.1, C22.2, C23.1, C24.2, C25.2, D2.1 (K), J2.11, J2.17, R3.2, R4.2; also elsewhere on the board
unnamed: C26.1, D2.2 (A), D3.1 (K)
unnamed: C26.2, D4.2 (A), L3.2, Q1.3 (D)

Notes on the sheet:
FPC24/0,5 connector to display ribbon cable
Bootstrapping display voltage generators
Use bottom contact connector

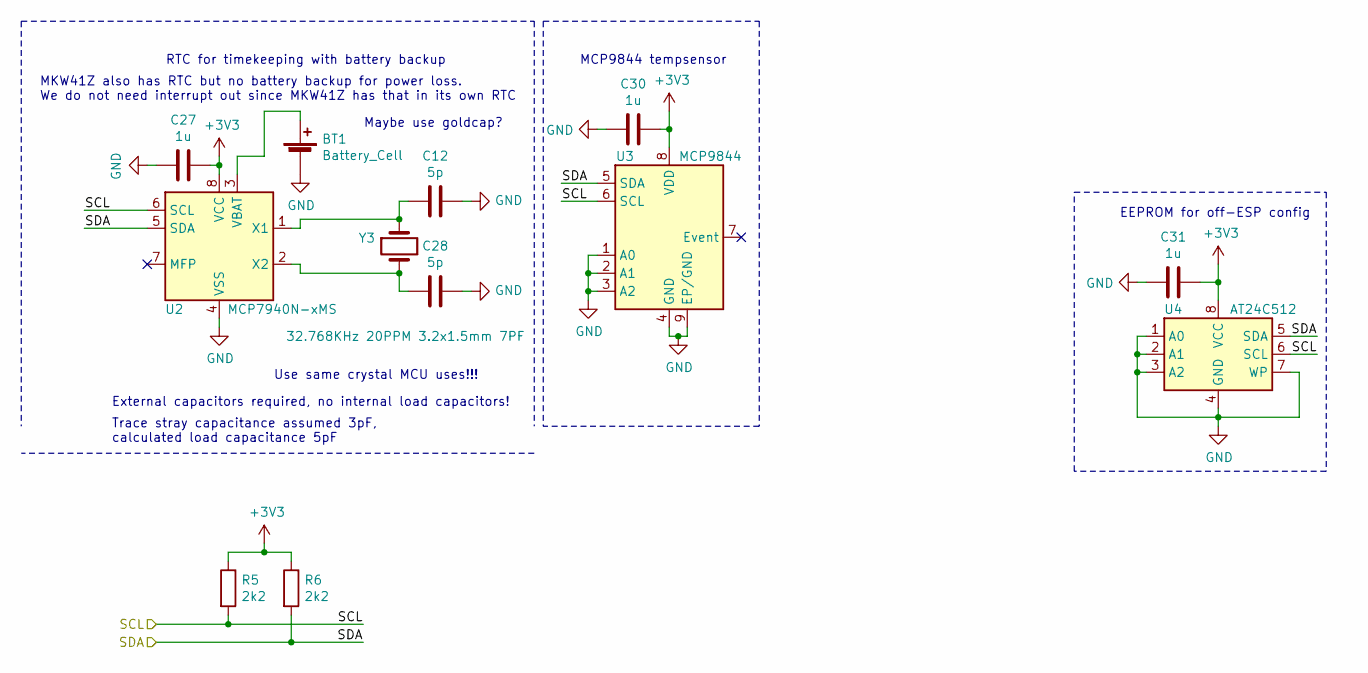
[picture p5: schematic sensors.sch]

Parts:
BT1: Battery_Cell; BatteryHolder_Keystone_3002_1x2032
C12, C28: 5p; C_0603_1608Metric
C27, C30, C31: 1u; C_0603_1608Metric
R5, R6: 2k2; R_0603_1608Metric
U2: MCP7940N-xMS; MSOP-8_3x3mm_P0.65mm
U3: MCP9844; DFN-8-1EP_3x2mm_P0.5mm_EP1.36x1.46mm
U4: AT24C512; DIP-8_W7.62mm_SMDSocket_SmallPads
Y3: 32.768KHz 20PPM 3.2x1.5mm 7PF; Crystal_SMD_3215-2Pin_3.2x1.5mm

Connections:
+3V3: C27.1, C30.1, C31.1, R5.1, R6.1, U2.8 (VCC), U3.8 (VDD), U4.8 (VCC); also elsewhere on the board
/I2C1_SCL: R5.2, U2.6 (SCL), U3.6 (SCL), U4.6 (SCL); also elsewhere on the board
/I2C1_SDA: R6.2, U2.5 (SDA), U3.5 (SDA), U4.5 (SDA); also elsewhere on the board
GND: BT1.2 (-), C12.1, C27.2, C28.1, C30.2, C31.2, U2.4 (VSS), U3.1 (A0), U3.2 (A1), U3.3 (A2), U3.4 (GND), U3.9 (EP/GND), U4.1 (A0), U4.2 (A1), U4.3 (A2), U4.4 (GND), U4.7 (WP); also elsewhere on the board
unnamed: BT1.1 (+), U2.3 (VBAT)
unnamed: C12.2, U2.1 (X1), Y3.1
unnamed: C28.2, U2.2 (X2), Y3.2

Notes on the sheet:
RTC for timekeeping with battery backup
Maybe use goldcap?
MCP9844 tempsensor
MKW41Z also has RTC but no battery backup for power loss. We do not need interrupt out since MKW41Z has that in its own RTC
EEPROM for off-ESP config
Use same crystal MCU uses!!!
External capacitors required, no internal load capacitors!
Trace stray capacitance assumed 3pF, calculated load capacitance 5pF

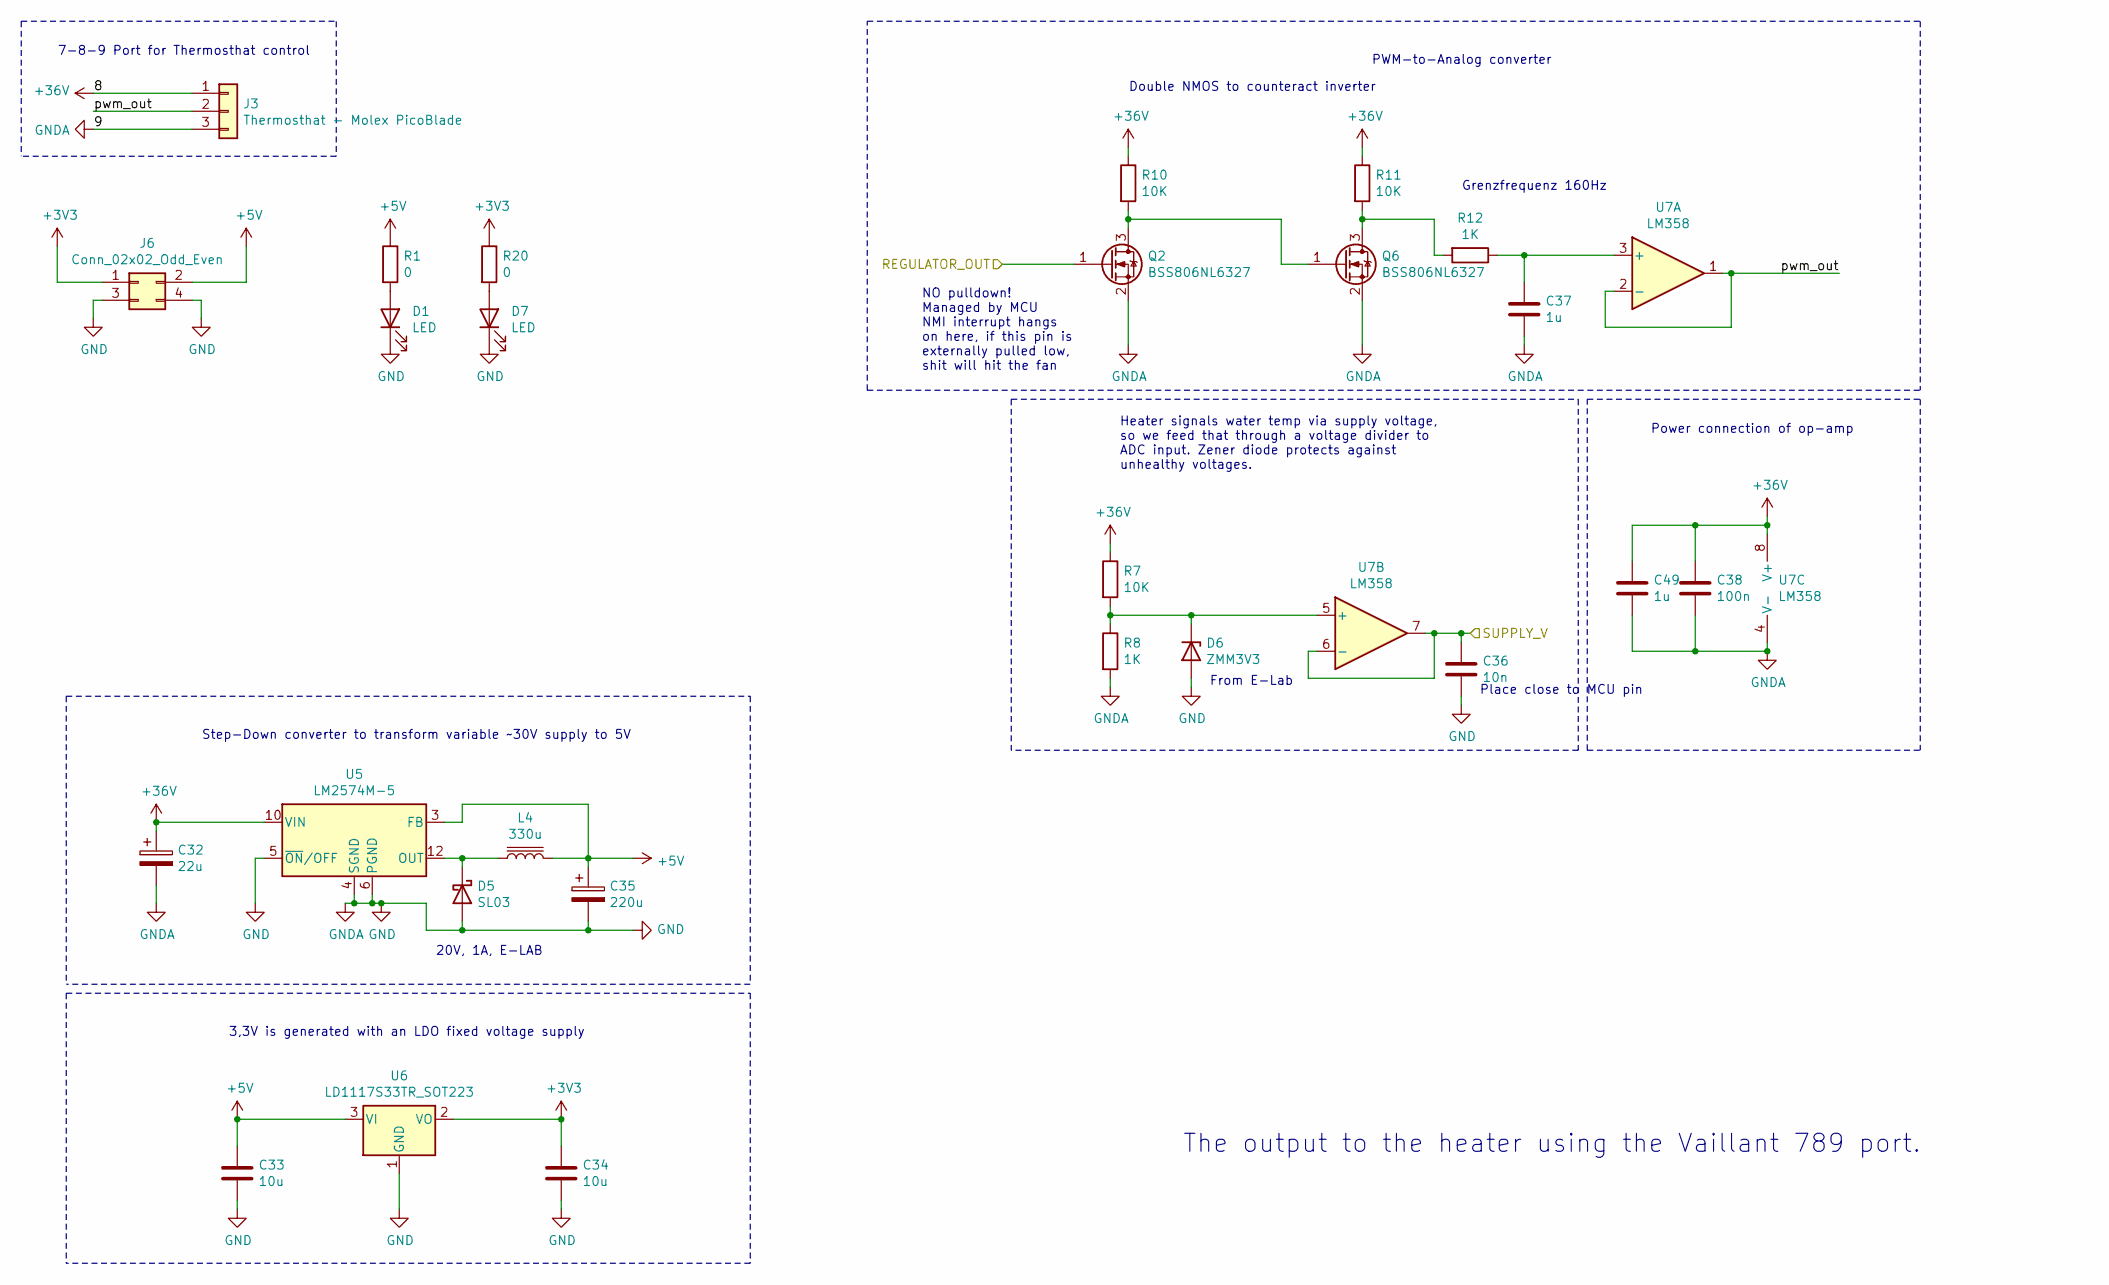
[picture p6: schematic regulator_out.sch]

Parts:
C32: 22u; CP_Elec_6.3x3
C33, C34: 10u; C_0603_1608Metric
C35: 220u; CP_Elec_6.3x5.4
C36: 10n; C_0402_1005Metric
C37, C49: 1u; C_0603_1608Metric
C38: 100n; C_0603_1608Metric
D1, D7: LED; LED_1210_3225Metric
D5: SL03; D_SMF
D6: ZMM3V3; D_MiniMELF
J3: Thermosthat - Molex PicoBlade; PinHeader_1x03_P2.54mm_Vertical_SMD_Pin1Left
J6: Conn_02x02_Odd_Even; PinHeader_2x02_P2.54mm_Vertical_SMD
L4: 330u; L_7.3x7.3_H3.5
Q2, Q6: BSS806NL6327; SOT-23
R1, R20: 0; R_0603_1608Metric
R7, R10, R11: 10K; R_0603_1608Metric
R8, R12: 1K; R_0603_1608Metric
U5: LM2574M-5; SOIC-14W_7.5x9mm_P1.27mm
U6: LD1117S33TR_SOT223; SOT-223-3_TabPin2
U7: LM358; SOIC-8_3.9x4.9mm_P1.27mm

Connections:
+3V3: C34.1, J6.1, R20.1, U6.2 (VO); also elsewhere on the board
+5V: C33.1, C35.1, J6.2, L4.2, R1.1, U5.3 (FB), U6.3 (VI); also elsewhere on the board
+36V: C32.1, C38.1, C49.1, J3.1, R7.1, R10.1, R11.1, U5.10 (VIN), U7.8 (V+)
/ADC_IN: C36.1, U7.6 (-), U7.7; also elsewhere on the board
/DAC0_OUT: Q2.1 (G); also elsewhere on the board
/regulator_out/pwm_out: J3.2, U7.1, U7.2 (-)
GND: C32.2, C33.2, C34.2, C35.2, C36.2, C37.2, C38.2, C49.2, D1.1 (K), D5.2 (A), D6.2 (A), D7.1 (K), J3.3, J6.3, J6.4, Q2.2 (S), Q6.2 (S), R8.2, U5.4 (SGND), U5.5 (~ON~/OFF), U5.6 (PGND), U6.1 (GND), U7.4 (V-); also elsewhere on the board
unnamed: C37.1, R12.1, U7.3 (+)
unnamed: D1.2 (A), R1.2
unnamed: D5.1 (K), L4.1, U5.12 (OUT)
unnamed: D6.1 (K), R7.2, R8.1, U7.5 (+)
unnamed: D7.2 (A), R20.2
unnamed: Q2.3 (D), Q6.1 (G), R10.2
unnamed: Q6.3 (D), R11.2, R12.2

Notes on the sheet:
The output to the heater using the Vaillant 789 port.
Power connection of op-amp
From E-Lab
Heater signals water temp via supply voltage, so we feed that through a voltage divider to ADC input. Zener diode protects against unhealthy voltages.
Grenzfrequenz 160Hz
PWM-to-Analog converter
7-8-9 Port for Thermosthat control
20V, 1A, E-LAB
Step-Down converter to transform variable ~~30V supply to 5V
3,3V is generated with an LDO fixed voltage supply
Place close to MCU pin
Double NMOS to counteract inverter
NO pulldown! Managed by MCU NMI interrupt hangs on here, if this pin is externally pulled low, shit will hit the fan

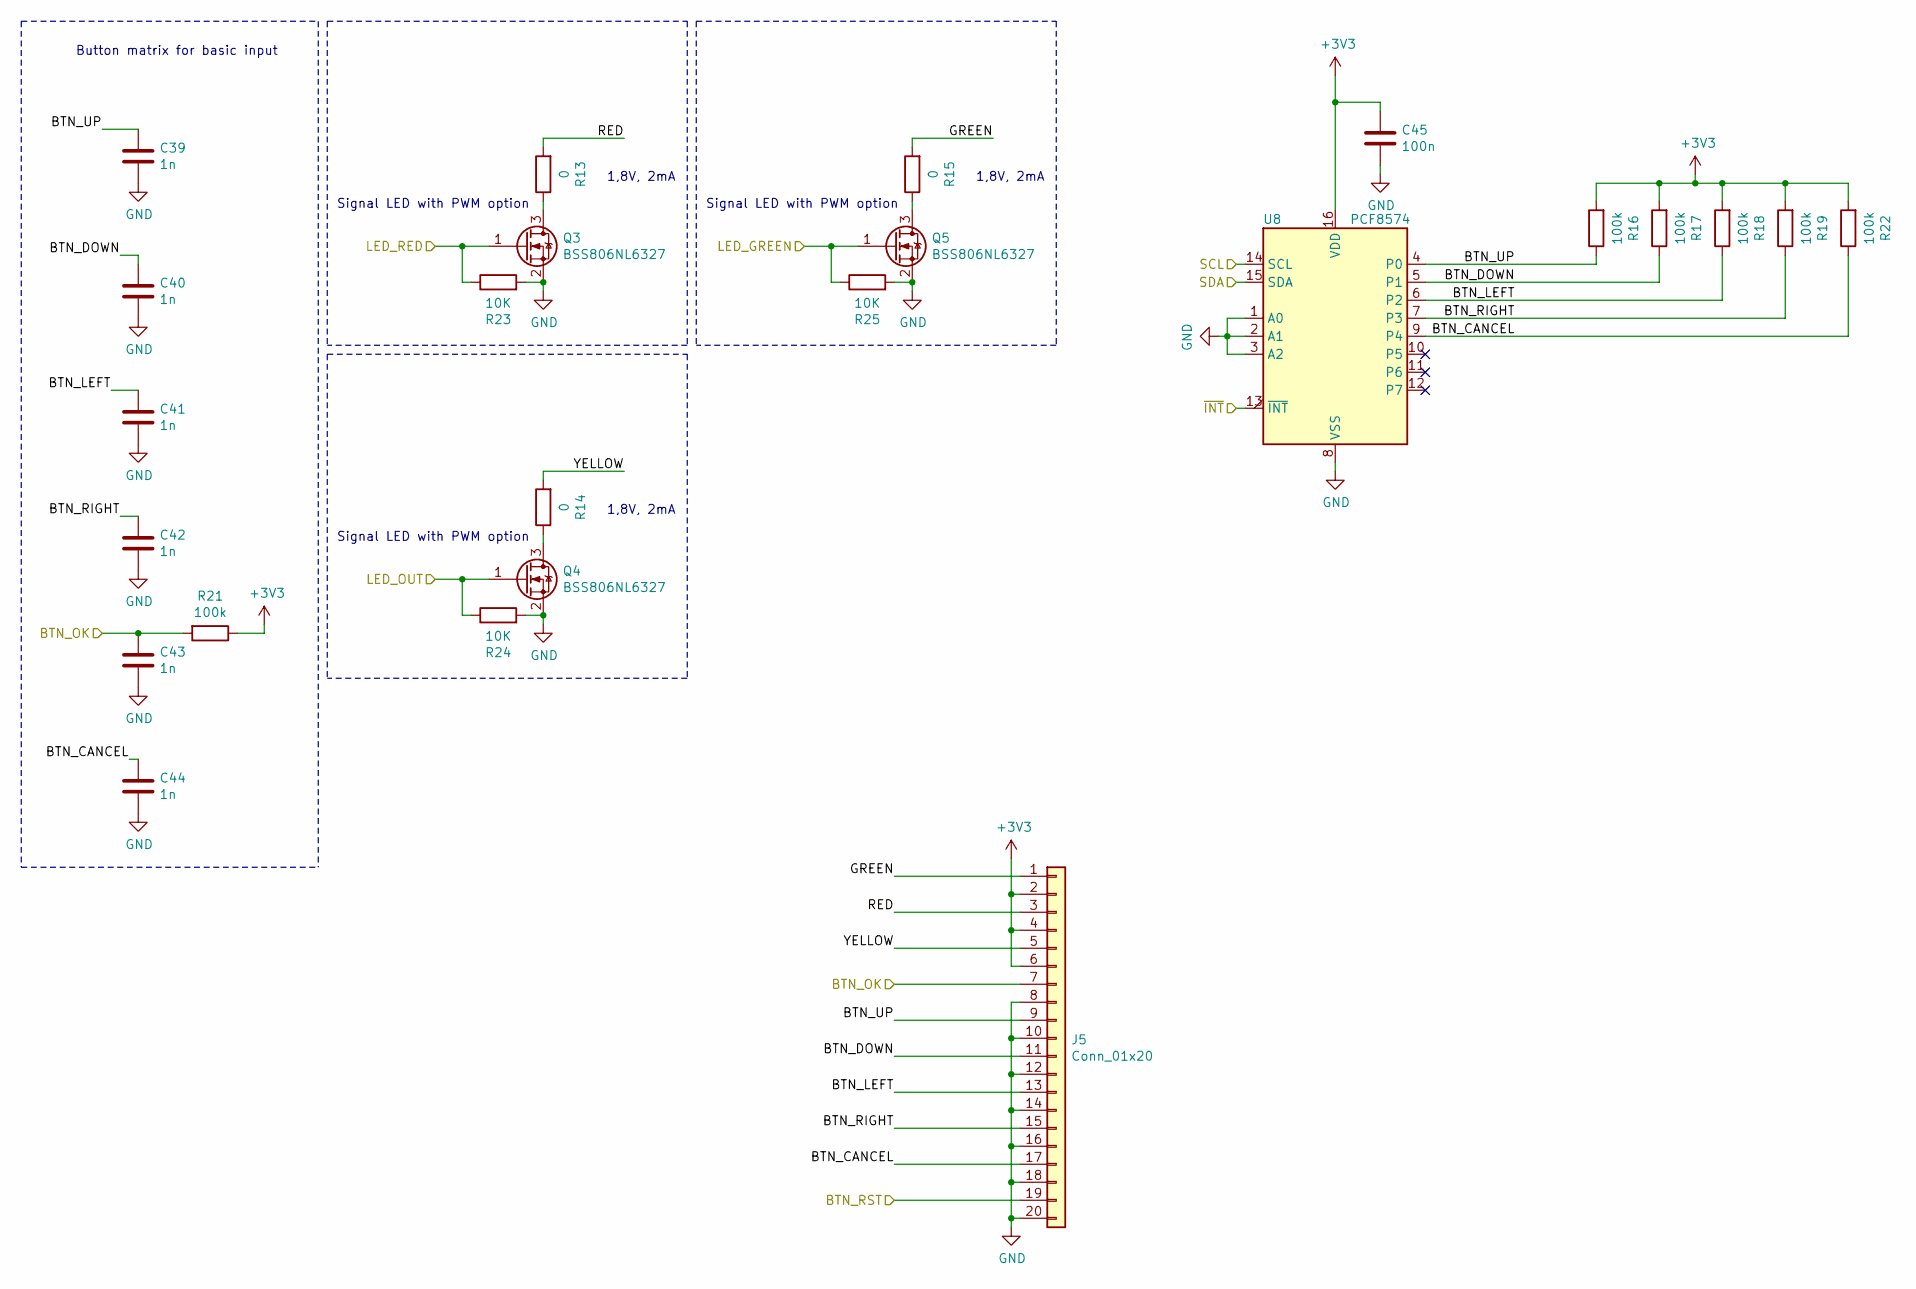
[picture p7: schematic gpio.sch]

Parts:
C39, C40, C41, C42, C43, C44: 1n; C_0402_1005Metric
C45: 100n; C_0603_1608Metric
J5: Conn_01x20; PinHeader_2x10_P2.54mm_Vertical_SMD
Q3, Q4, Q5: BSS806NL6327; SOT-23
R13, R14, R15: 0; R_0603_1608Metric
R16, R17, R18, R19, R21, R22: 100k; R_0402_1005Metric
R23, R24, R25: 10K; R_0402_1005Metric
U8: PCF8574; SOIC-16W_7.5x10.3mm_P1.27mm

Connections:
+3V3: C45.1, J5.2, J5.4, J5.6, R16.2, R17.2, R18.2, R19.2, R21.1, R22.2, U8.16 (VDD); also elsewhere on the board
/BTN_OK: C43.1, J5.7, R21.2; also elsewhere on the board
/GPIO/BTN_CANCEL: C44.1, J5.17, R22.1, U8.9 (P4)
/GPIO/BTN_DOWN: C40.1, J5.11, R17.1, U8.5 (P1)
/GPIO/BTN_LEFT: C41.1, J5.13, R18.1, U8.6 (P2)
/GPIO/BTN_RIGHT: C42.1, J5.15, R19.1, U8.7 (P3)
/GPIO/BTN_UP: C39.1, J5.9, R16.1, U8.4 (P0)
/GPIO/GREEN: J5.1, R15.2
/GPIO/RED: J5.3, R13.2
/GPIO/YELLOW: J5.5, R14.2
/I2C1_SCL: U8.14 (SCL); also elsewhere on the board
/I2C1_SDA: U8.15 (SDA); also elsewhere on the board
/RESET_b: J5.19; also elsewhere on the board
/TPM0_CH1: Q4.1 (G), R24.1; also elsewhere on the board
/TPM0_CH2: Q3.1 (G), R23.1; also elsewhere on the board
/TPM0_CH3: Q5.1 (G), R25.1; also elsewhere on the board
/~BTN_INT: U8.13 (~INT~); also elsewhere on the board
GND: C39.2, C40.2, C41.2, C42.2, C43.2, C44.2, C45.2, J5.8, J5.10, J5.12, J5.14, J5.16, J5.18, J5.20, Q3.2 (S), Q4.2 (S), Q5.2 (S), R23.2, R24.2, R25.2, U8.1 (A0), U8.2 (A1), U8.3 (A2), U8.8 (VSS); also elsewhere on the board
unnamed: Q3.3 (D), R13.1
unnamed: Q4.3 (D), R14.1
unnamed: Q5.3 (D), R15.1

Notes on the sheet:
Button matrix for basic input
Signal LED with PWM option
1,8V, 2mA

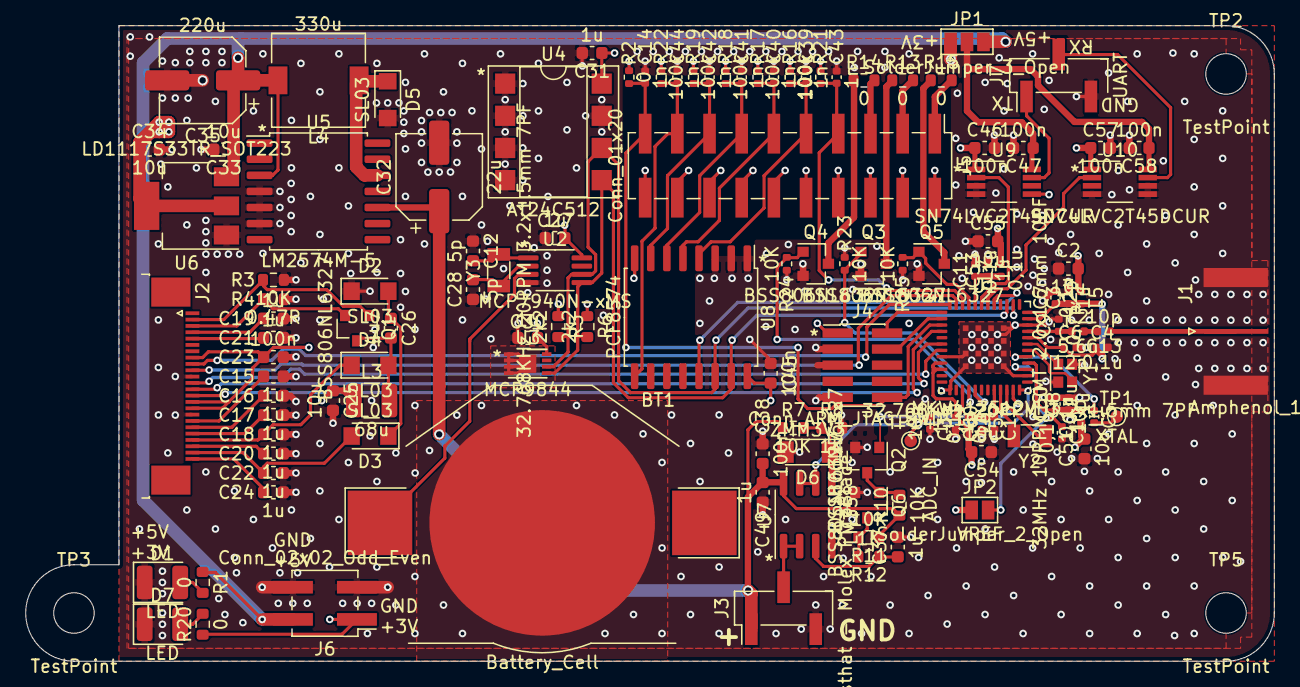
[picture p8: board home-thermostat.kicad_pcb from above]

Board: 4 copper layers, 98.6 x 50.2 mm, 128 parts (0 on the bottom side), 75 nets.
