matyas1995/home-thermosthat/tempsensor/tempsensor.kicad_pcb

## KiCad design tempsensor/tempsensor.kicad_pcb (2020-12-08)

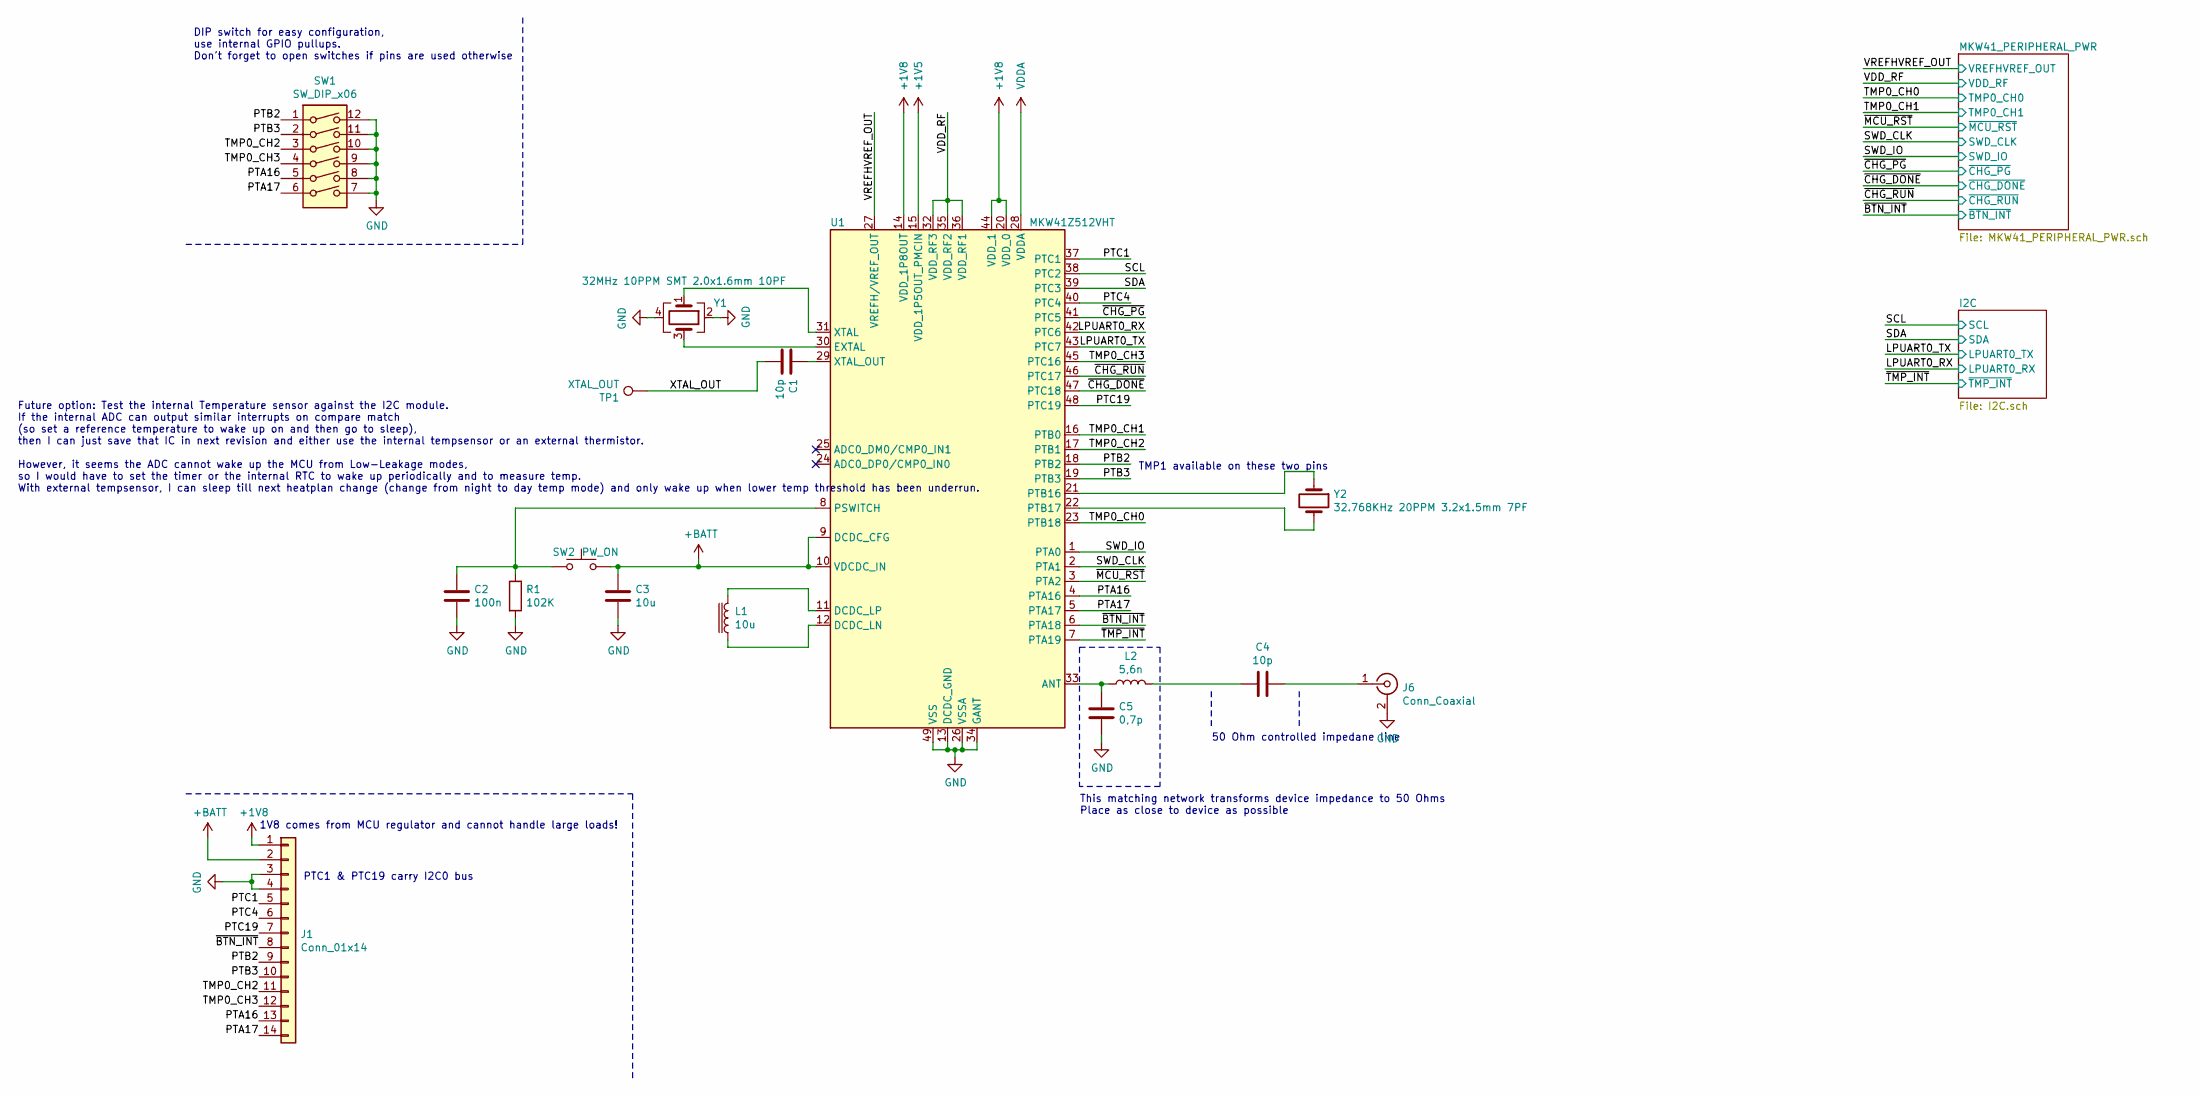
[picture p9: schematic tempsensor.sch]

Parts:
C1, C4: 10p; C_0402_1005Metric
C2: 100n; C_0402_1005Metric
C3: 10u; C_0603_1608Metric
C5: 0,7p; C_0402_1005Metric
J1: Conn_01x14; PinHeader_2x07_P2.54mm_Vertical
J6: Conn_Coaxial; SMA_Amphenol_132289_EdgeMount
L1: 10u; L_Wuerth_MAPI-3012
L2: 5,6n; L_0402_1005Metric
R1: 102K; R_0402_1005Metric
SW1: SW_DIP_x06; SW_DIP_SPSTx06_Slide_Omron_A6S-610x_W8.9mm_P2.54mm
SW2: PW_ON; SW_PUSH_6mm_H5mm
TP1: XTAL_OUT; TestPoint_Pad_D1.0mm
U1: MKW41Z512VHT; NXP_LQFN-48-1EP_7x7mm_P0.5mm_EP3.5x3.5mm_16xMask0.45x0.45
Y1: 32MHz 10PPM SMT 2.0x1.6mm 10PF; Crystal_SMD_2016-4Pin_2.0x1.6mm
Y2: 32.768KHz 20PPM 3.2x1.5mm 7PF; Crystal_SMD_3215-2Pin_3.2x1.5mm

Connections:
+1V5: U1.15 (VDD_1P5OUT_PMCIN); also elsewhere on the board
+1V8: J1.1, U1.14 (VDD_1P8OUT), U1.20 (VDD_0), U1.44 (VDD_1); also elsewhere on the board
+BATT: C3.1, J1.2, SW2.2, U1.9 (DCDC_CFG), U1.10 (VDCDC_IN); also elsewhere on the board
/LPUART0_RX: U1.42 (PTC6); also elsewhere on the board
/LPUART0_TX: U1.43 (PTC7); also elsewhere on the board
/PTA16: J1.13, SW1.5, U1.4 (PTA16)
/PTA17: J1.14, SW1.6, U1.5 (PTA17)
/PTB2: J1.9, SW1.1, U1.18 (PTB2)
/PTB3: J1.10, SW1.2, U1.19 (PTB3)
/PTC1: J1.5, U1.37 (PTC1)
/PTC4: J1.6, U1.40 (PTC4)
/PTC19: J1.7, U1.48 (PTC19)
/SCL: U1.38 (PTC2); also elsewhere on the board
/SDA: U1.39 (PTC3); also elsewhere on the board
/SWD_CLK: U1.2 (PTA1); also elsewhere on the board
/SWD_IO: U1.1 (PTA0); also elsewhere on the board
/TMP0_CH0: U1.23 (PTB18); also elsewhere on the board
/TMP0_CH1: U1.16 (PTB0); also elsewhere on the board
/TMP0_CH2: J1.11, SW1.3, U1.17 (PTB1)
/TMP0_CH3: J1.12, SW1.4, U1.45 (PTC16)
/VDD_RF: U1.32 (VDD_RF3), U1.35 (VDD_RF2), U1.36 (VDD_RF1); also elsewhere on the board
/VREFHVREF_OUT: U1.27 (VREFH/VREF_OUT); also elsewhere on the board
/XTAL_OUT: C1.2, TP1.1
/~BTN_INT: J1.8, U1.6 (PTA18); also elsewhere on the board
/~CHG_DONE: U1.47 (PTC18); also elsewhere on the board
/~CHG_PG: U1.41 (PTC5); also elsewhere on the board
/~CHG_RUN: U1.46 (PTC17); also elsewhere on the board
/~MCU_RST: U1.3 (PTA2); also elsewhere on the board
/~TMP_INT: U1.7 (PTA19); also elsewhere on the board
GND: C2.2, C3.2, C5.2, J1.3, J1.4, J6.2 (Ext), R1.2, SW1.7, SW1.8, SW1.9, SW1.10, SW1.11, SW1.12, U1.13 (DCDC_GND), U1.26 (VSSA), U1.34 (GANT), U1.49 (VSS), Y1.2, Y1.4; also elsewhere on the board
unnamed: C1.1, U1.29 (XTAL_OUT)
unnamed: C2.1, R1.1, SW2.1, U1.8 (PSWITCH)
unnamed: C4.1, J6.1 (In)
unnamed: C4.2, L2.2
unnamed: C5.1, L2.1, U1.33 (ANT)
unnamed: L1.1, U1.12 (DCDC_LN)
unnamed: L1.2, U1.11 (DCDC_LP)
unnamed: U1.21 (PTB16), Y2.1
unnamed: U1.22 (PTB17), Y2.2
unnamed: U1.30 (EXTAL), Y1.3
unnamed: U1.31 (XTAL), Y1.1
VDDA: U1.28 (VDDA); also elsewhere on the board

Notes on the sheet:
This matching network transforms device impedance to 50 Ohms Place as close to device as possible
50 Ohm controlled impedane line
TMP1 available on these two pins
PTC1 & PTC19 carry I2C0 bus
DIP switch for easy configuration, use internal GPIO pullups. Don't forget to open switches if pins are used otherwise
1V8 comes from MCU regulator and cannot handle large loads!
Future option: Test the internal Temperature sensor against the I2C module. If the internal ADC can output similar interrupts on compare match (so set a reference temperature to wake up on and then go to sleep), then I can just save that IC in next revision and either use the internal tempsensor or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
