matyas1995/home-thermosthat/tempsensor/tempsensor.kicad_pcb

## KiCad design tempsensor/tempsensor.kicad_pcb (continued)

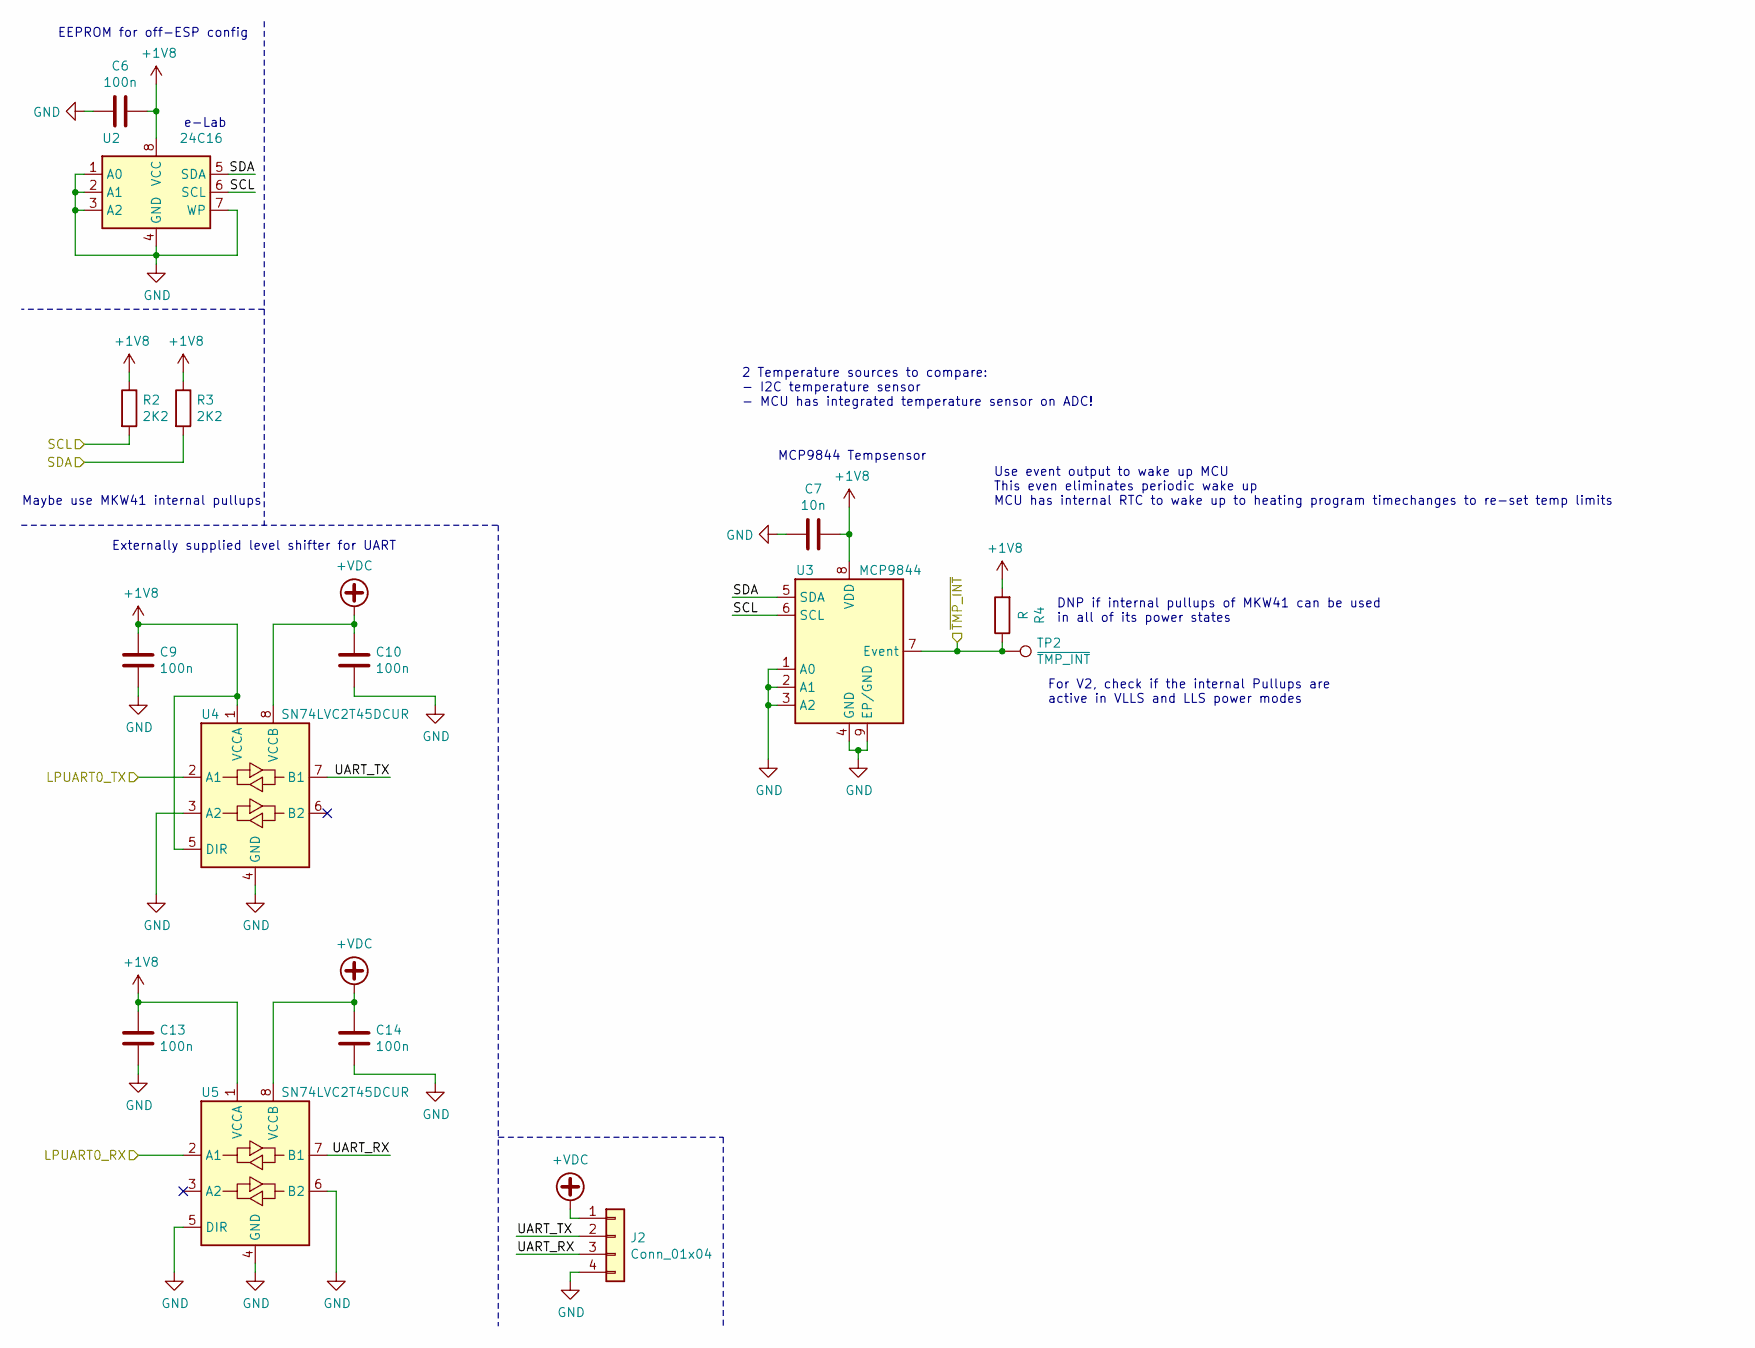
[picture p10: schematic I2C.sch]

Parts:
C6: 100n; C_0603_1608Metric
C7: 10n; C_0603_1608Metric
C9, C10, C13, C14: 100n; C_0402_1005Metric
J2: Conn_01x04; PinHeader_2x02_P2.54mm_Vertical
R2, R3: 2K2; R_0603_1608Metric
R4: R; R_0402_1005Metric
TP2: ~TMP_INT; TestPoint_Pad_D1.0mm
U2: 24C16; SOIC-8_3.9x4.9mm_P1.27mm
U3: MCP9844; DFN-8-1EP_3x2mm_P0.5mm_EP1.36x1.46mm
U4, U5: SN74LVC2T45DCUR; VSSOP-8_2.4x2.1mm_P0.5mm

Connections:
+1V8: C6.1, C7.1, C9.1, C13.1, R2.1, R3.1, R4.2, U2.8 (VCC), U3.8 (VDD), U4.1 (VCCA), U4.5 (DIR), U5.1 (VCCA); also elsewhere on the board
+VDC: C10.1, C14.1, J2.1, U4.8 (VCCB), U5.8 (VCCB)
/I2C/UART_RX: J2.3, U5.7 (B1)
/I2C/UART_TX: J2.2, U4.7 (B1)
/LPUART0_RX: U5.2 (A1); also elsewhere on the board
/LPUART0_TX: U4.2 (A1); also elsewhere on the board
/SCL: R2.2, U2.6 (SCL), U3.6 (SCL); also elsewhere on the board
/SDA: R3.2, U2.5 (SDA), U3.5 (SDA); also elsewhere on the board
/~TMP_INT: R4.1, TP2.1, U3.7 (Event); also elsewhere on the board
GND: C6.2, C7.2, C9.2, C10.2, C13.2, C14.2, J2.4, U2.1 (A0), U2.2 (A1), U2.3 (A2), U2.4 (GND), U2.7 (WP), U3.1 (A0), U3.2 (A1), U3.3 (A2), U3.4 (GND), U3.9 (EP/GND), U4.3 (A2), U4.4 (GND), U5.4 (GND), U5.5 (DIR), U5.6 (B2); also elsewhere on the board

Notes on the sheet:
EEPROM for off-ESP config
e-Lab
MCP9844 Tempsensor
Use event output to wake up MCU This even eliminates periodic wake up MCU has internal RTC to wake up to heating program timechanges to re-set temp limits
DNP if internal pullups of MKW41 can be used in all of its power states
For V2, check if the internal Pullups are active in VLLS and LLS power modes
Externally supplied level shifter for UART
Maybe use MKW41 internal pullups
2 Temperature sources to compare: - I2C temperature sensor - MCU has integrated temperature sensor on ADC!

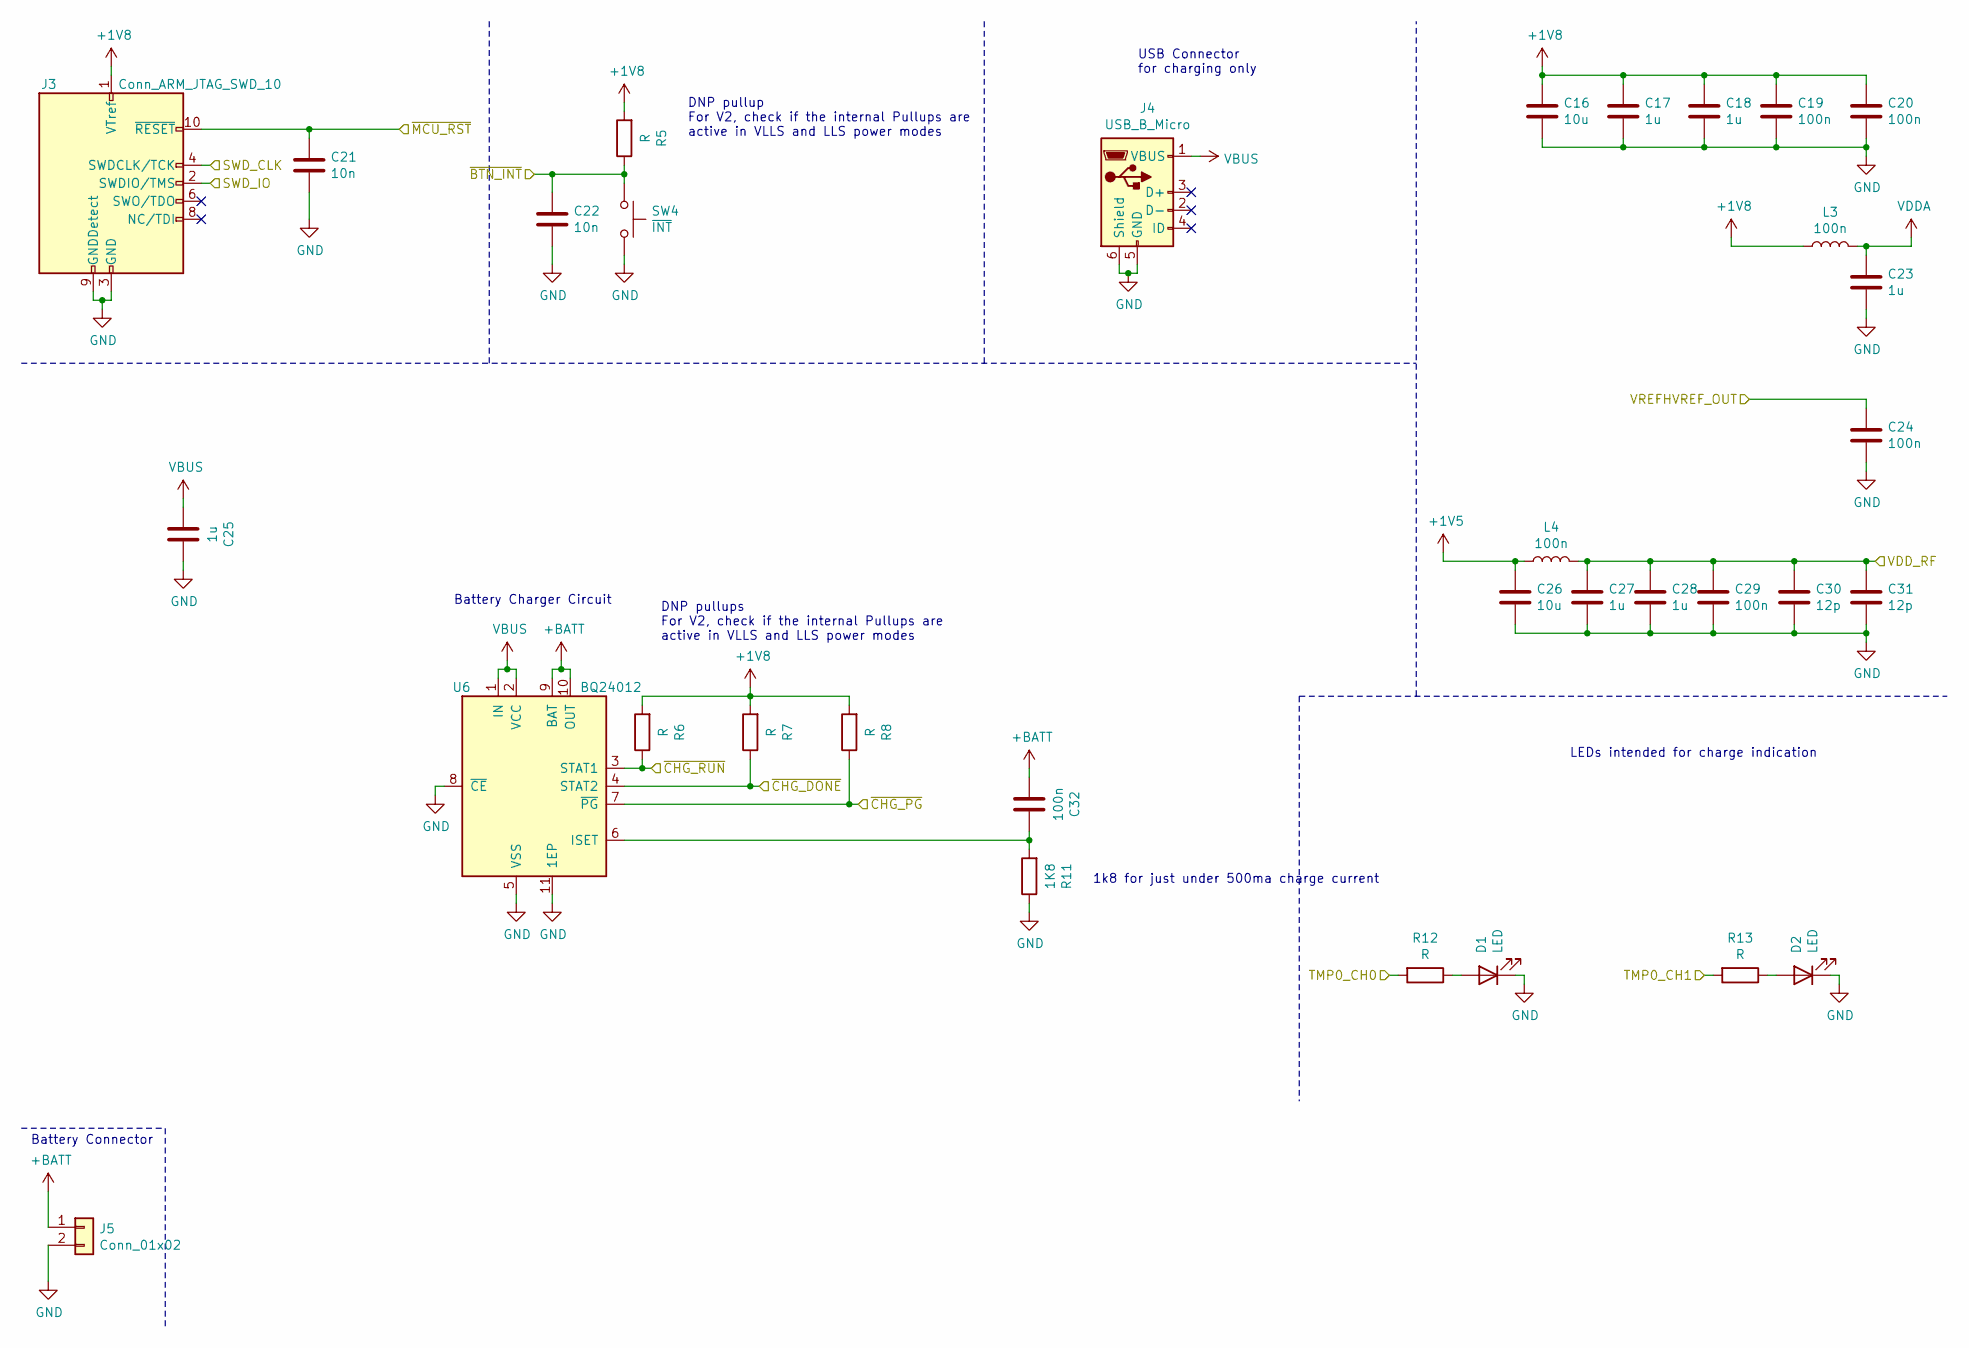
[picture p11: schematic MKW41_PERIPHERAL_PWR.sch]

Parts:
C16, C26: 10u; C_0603_1608Metric
C17, C18, C23, C27, C28: 1u; C_0402_1005Metric
C19, C20, C24, C29, C32: 100n; C_0402_1005Metric
C21, C22: 10n; C_0402_1005Metric
C25: 1u; C_0603_1608Metric
C30, C31: 12p; C_0402_1005Metric
D1, D2: LED; LED_0603_1608Metric
J3: Conn_ARM_JTAG_SWD_10; PinHeader_2x05_P1.27mm_Vertical_SMD
J4: USB_B_Micro; USB-Mini-B_Wuerth_651005136521_Horizontal
J5: Conn_01x02; PinHeader_1x02_P2.54mm_Vertical
L3, L4: 100n; L_0402_1005Metric
R5, R12, R13: R; R_0603_1608Metric
R6, R7, R8: R; R_0402_1005Metric
R11: 1K8; R_0402_1005Metric
SW4: ~INT; SW_PUSH_6mm_H5mm
U6: BQ24012; VSON-10-1EP_3x3mm_P0.5mm_EP1.65x2.4mm_ThermalVias

Connections:
+1V5: C26.1, L4.1; also elsewhere on the board
+1V8: C16.1, C17.1, C18.1, C19.1, C20.1, J3.1 (VTref), L3.1, R5.2, R6.2, R7.2, R8.2; also elsewhere on the board
+BATT: C32.2, J5.1, U6.9 (BAT), U6.10 (OUT); also elsewhere on the board
/SWD_CLK: J3.4 (SWDCLK/TCK); also elsewhere on the board
/SWD_IO: J3.2 (SWDIO/TMS); also elsewhere on the board
/TMP0_CH0: R12.2; also elsewhere on the board
/TMP0_CH1: R13.2; also elsewhere on the board
/VDD_RF: C27.1, C28.1, C29.1, C30.1, C31.1, L4.2; also elsewhere on the board
/VREFHVREF_OUT: C24.1; also elsewhere on the board
/~BTN_INT: C22.1, R5.1, SW4.1; also elsewhere on the board
/~CHG_DONE: R7.1, U6.4 (STAT2); also elsewhere on the board
/~CHG_PG: R8.1, U6.7 (~PG); also elsewhere on the board
/~CHG_RUN: R6.1, U6.3 (STAT1); also elsewhere on the board
/~MCU_RST: C21.1, J3.10 (~RESET~); also elsewhere on the board
GND: C16.2, C17.2, C18.2, C19.2, C20.2, C21.2, C22.2, C23.2, C24.2, C25.1, C26.2, C27.2, C28.2, C29.2, C30.2, C31.2, D1.1 (K), D2.1 (K), J3.3 (GND), J3.5 (GND), J3.9 (GNDDetect), J4.5 (GND), J4.6 (Shield), J5.2, R11.1, SW4.2, U6.5 (VSS), U6.8 (~CE), U6.11 (1EP); also elsewhere on the board
unnamed: C32.1, R11.2, U6.6 (ISET)
unnamed: D1.2 (A), R12.1
unnamed: D2.2 (A), R13.1
VBUS: C25.2, J4.1 (VBUS), U6.1 (IN), U6.2 (VCC)
VDDA: C23.1, L3.2; also elsewhere on the board

Notes on the sheet:
DNP pullup For V2, check if the internal Pullups are active in VLLS and LLS power modes
Battery Connector
Battery Charger Circuit
USB Connector for charging only
DNP pullups For V2, check if the internal Pullups are active in VLLS and LLS power modes
LEDs intended for charge indication
1k8 for just under 500ma charge current

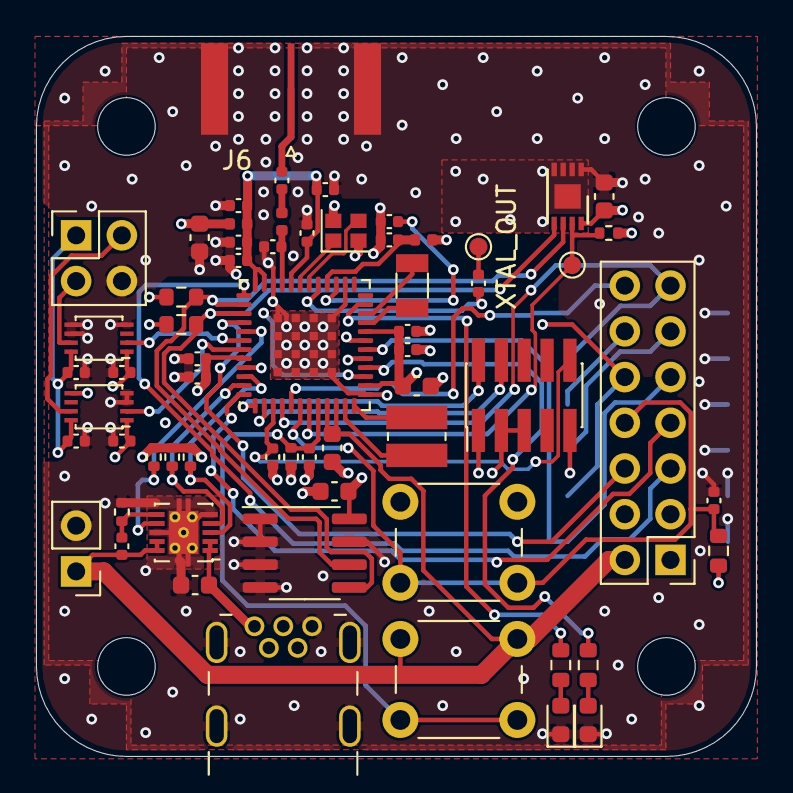
[picture p12: board tempsensor.kicad_pcb from above]

Board: 4 copper layers, 40.0 x 40.0 mm, 64 parts (1 on the bottom side), 49 nets.
