matyas1995/home-thermosthat/firmware/kw41_startup/startup_mkw41z4.c

//*****************************************************************************
// MKW41Z4 startup code for use with MCUXpresso IDE
//
// Version : 050117
//*****************************************************************************
//
// Copyright(C) NXP Semiconductors, 2017
// All rights reserved.
//
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
// o Neither the name of copyright holder nor the names of its
//   contributors may be used to endorse or promote products derived from this
//   software without specific prior written permission.
//
// THIS SOFTWARE IS PROVIDED BY THE COPYRIGHT HOLDERS AND CONTRIBUTORS "AS IS" AND
// ANY EXPRESS OR IMPLIED WARRANTIES, INCLUDING, BUT NOT LIMITED TO, THE IMPLIED
// WARRANTIES OF MERCHANTABILITY AND FITNESS FOR A PARTICULAR PURPOSE ARE
// DISCLAIMED. IN NO EVENT SHALL THE COPYRIGHT HOLDER OR CONTRIBUTORS BE LIABLE FOR
// ANY DIRECT, INDIRECT, INCIDENTAL, SPECIAL, EXEMPLARY, OR CONSEQUENTIAL DAMAGES
// (INCLUDING, BUT NOT LIMITED TO, PROCUREMENT OF SUBSTITUTE GOODS OR SERVICES;
// LOSS OF USE, DATA, OR PROFITS; OR BUSINESS INTERRUPTION) HOWEVER CAUSED AND ON
// ANY THEORY OF LIABILITY, WHETHER IN CONTRACT, STRICT LIABILITY, OR TORT
// (INCLUDING NEGLIGENCE OR OTHERWISE) ARISING IN ANY WAY OUT OF THE USE OF THIS
// SOFTWARE, EVEN IF ADVISED OF THE POSSIBILITY OF SUCH DAMAGE.
//*****************************************************************************

#if defined (DEBUG)
#pragma GCC push_options
#pragma GCC optimize ("Og")
#endif // (DEBUG)

#if defined (__cplusplus)
#ifdef __REDLIB__
#error Redlib does not support C++
#else
//*****************************************************************************
//
// The entry point for the C++ library startup
//
//*****************************************************************************
extern "C" {
    extern void __libc_init_array(void);
}
#endif
#endif

#define WEAK __attribute__ ((weak))
#define WEAK_AV __attribute__ ((weak, section(".after_vectors")))
#define ALIAS(f) __attribute__ ((weak, alias (#f)))

//*****************************************************************************
#if defined (__cplusplus)
extern "C" {
#endif

//*****************************************************************************
// Flash Configuration block : 16-byte flash configuration field that stores
// default protection settings (loaded on reset) and security information that
// allows the MCU to restrict access to the Flash Memory module.
// Placed at address 0x400 by the linker script.
//*****************************************************************************

__attribute__ ((used,section(".FlashConfig"))) const struct {
    unsigned int word1;
    unsigned int word2;
    unsigned int word3;
    unsigned int word4;
} Flash_Config = {0xFFFFFFFF, 0xFFFFFFFF, 0xFFFFFFFF, 0xFFFFFFFE};

//*****************************************************************************
// Declaration of external SystemInit function
//*****************************************************************************
#if defined (__USE_CMSIS)
extern void SystemInit(void);
#endif // (__USE_CMSIS)

//*****************************************************************************
// Forward declaration of the core exception handlers.
// When the application defines a handler (with the same name), this will
// automatically take precedence over these weak definitions
//*****************************************************************************
     void Reset_Handler(void);
WEAK void NMI_Handler(void);
WEAK void HardFault_Handler(void);
WEAK void SVC_Handler(void);
WEAK void PendSV_Handler(void);
WEAK void SysTick_Handler(void);
WEAK void IntDefaultHandler(void);

//*****************************************************************************
// Forward declaration of the application IRQ handlers. When the application
// defines a handler (with the same name), this will automatically take
// precedence over weak definitions below
//*****************************************************************************
WEAK void DMA0_IRQHandler(void);
WEAK void DMA1_IRQHandler(void);
WEAK void DMA2_IRQHandler(void);
WEAK void DMA3_IRQHandler(void);
WEAK void Reserved20_IRQHandler(void);
WEAK void FTFA_IRQHandler(void);
WEAK void LVD_LVW_DCDC_IRQHandler(void);
WEAK void LLWU_IRQHandler(void);
WEAK void I2C0_IRQHandler(void);
WEAK void I2C1_IRQHandler(void);
WEAK void SPI0_IRQHandler(void);
WEAK void TSI0_IRQHandler(void);
WEAK void LPUART0_IRQHandler(void);
WEAK void TRNG0_IRQHandler(void);
WEAK void CMT_IRQHandler(void);
WEAK void ADC0_IRQHandler(void);
WEAK void CMP0_IRQHandler(void);
WEAK void TPM0_IRQHandler(void);
WEAK void TPM1_IRQHandler(void);
WEAK void TPM2_IRQHandler(void);
WEAK void RTC_IRQHandler(void);
WEAK void RTC_Seconds_IRQHandler(void);
WEAK void PIT_IRQHandler(void);
WEAK void LTC0_IRQHandler(void);
WEAK void Radio_0_IRQHandler(void);
WEAK void DAC0_IRQHandler(void);
WEAK void Radio_1_IRQHandler(void);
WEAK void MCG_IRQHandler(void);
WEAK void LPTMR0_IRQHandler(void);
WEAK void SPI1_IRQHandler(void);
WEAK void PORTA_IRQHandler(void);
WEAK void PORTB_PORTC_IRQHandler(void);

//*****************************************************************************
// Forward declaration of the driver IRQ handlers. These are aliased
// to the IntDefaultHandler, which is a 'forever' loop. When the driver
// defines a handler (with the same name), this will automatically take
// precedence over these weak definitions
//*****************************************************************************
void DMA0_DriverIRQHandler(void) ALIAS(IntDefaultHandler);
void DMA1_DriverIRQHandler(void) ALIAS(IntDefaultHandler);
void DMA2_DriverIRQHandler(void) ALIAS(IntDefaultHandler);
void DMA3_DriverIRQHandler(void) ALIAS(IntDefaultHandler);
void Reserved20_DriverIRQHandler(void) ALIAS(IntDefaultHandler);
void FTFA_DriverIRQHandler(void) ALIAS(IntDefaultHandler);
void LVD_LVW_DCDC_DriverIRQHandler(void) ALIAS(IntDefaultHandler);
void LLWU_DriverIRQHandler(void) ALIAS(IntDefaultHandler);
void I2C0_DriverIRQHandler(void) ALIAS(IntDefaultHandler);
void I2C1_DriverIRQHandler(void) ALIAS(IntDefaultHandler);
void SPI0_DriverIRQHandler(void) ALIAS(IntDefaultHandler);
void TSI0_DriverIRQHandler(void) ALIAS(IntDefaultHandler);
void LPUART0_DriverIRQHandler(void) ALIAS(IntDefaultHandler);
void TRNG0_DriverIRQHandler(void) ALIAS(IntDefaultHandler);
void CMT_DriverIRQHandler(void) ALIAS(IntDefaultHandler);
void ADC0_DriverIRQHandler(void) ALIAS(IntDefaultHandler);
void CMP0_DriverIRQHandler(void) ALIAS(IntDefaultHandler);
void TPM0_DriverIRQHandler(void) ALIAS(IntDefaultHandler);
void TPM1_DriverIRQHandler(void) ALIAS(IntDefaultHandler);
void TPM2_DriverIRQHandler(void) ALIAS(IntDefaultHandler);
void RTC_DriverIRQHandler(void) ALIAS(IntDefaultHandler);
void RTC_Seconds_DriverIRQHandler(void) ALIAS(IntDefaultHandler);
void PIT_DriverIRQHandler(void) ALIAS(IntDefaultHandler);
void LTC0_DriverIRQHandler(void) ALIAS(IntDefaultHandler);
void Radio_0_DriverIRQHandler(void) ALIAS(IntDefaultHandler);
void DAC0_DriverIRQHandler(void) ALIAS(IntDefaultHandler);
void Radio_1_DriverIRQHandler(void) ALIAS(IntDefaultHandler);
void MCG_DriverIRQHandler(void) ALIAS(IntDefaultHandler);
void LPTMR0_DriverIRQHandler(void) ALIAS(IntDefaultHandler);
void SPI1_DriverIRQHandler(void) ALIAS(IntDefaultHandler);
void PORTA_DriverIRQHandler(void) ALIAS(IntDefaultHandler);
void PORTB_PORTC_DriverIRQHandler(void) ALIAS(IntDefaultHandler);

//*****************************************************************************
// The entry point for the application.
//*****************************************************************************
extern int main(void);

//*****************************************************************************
// External declaration for the pointer to the stack top from the Linker Script
//*****************************************************************************
extern void __StackTop(void);

//*****************************************************************************
#if defined (__cplusplus)
} // extern "C"
#endif

//*****************************************************************************
// The vector table.
// This relies on the linker script to place at correct location in memory.
//*****************************************************************************
extern void (* const g_pfnVectors[])(void);
extern void * __Vectors __attribute__ ((alias ("g_pfnVectors")));

__attribute__ ((used, section(".isr_vector")))
void (* const g_pfnVectors[])(void) = {
    // Core Level - CM0P
    &__StackTop,                       // The initial stack pointer
    Reset_Handler,                          // The reset handler
    NMI_Handler,                       // The NMI handler
    HardFault_Handler,                 // The hard fault handler
    0,                                 // Reserved
    0,                                 // Reserved
    0,                                 // Reserved
    0,                                 // Reserved
    0,                                 // Reserved
    0,                                 // Reserved
    0,                                 // Reserved
    SVC_Handler,                       // SVCall handler
    0,                                 // Reserved
    0,                                 // Reserved
    PendSV_Handler,                    // The PendSV handler
    SysTick_Handler,                   // The SysTick handler

    // Chip Level - MKW41Z4
    DMA0_IRQHandler,          // 16: DMA channel 0 transfer complete
    DMA1_IRQHandler,          // 17: DMA channel 1 transfer complete
    DMA2_IRQHandler,          // 18: DMA channel 2 transfer complete
    DMA3_IRQHandler,          // 19: DMA channel 3 transfer complete
    Reserved20_IRQHandler,    // 20: Reserved interrupt
    FTFA_IRQHandler,          // 21: Command complete and read collision
    LVD_LVW_DCDC_IRQHandler,  // 22: Low-voltage detect, low-voltage warning, DCDC
    LLWU_IRQHandler,          // 23: Low leakage wakeup Unit
    I2C0_IRQHandler,          // 24: I2C0 interrupt
    I2C1_IRQHandler,          // 25: I2C1 interrupt
    SPI0_IRQHandler,          // 26: SPI0 single interrupt vector for all sources
    TSI0_IRQHandler,          // 27: TSI0 single interrupt vector for all sources
    LPUART0_IRQHandler,       // 28: LPUART0 status and error
    TRNG0_IRQHandler,         // 29: TRNG0 interrupt
    CMT_IRQHandler,           // 30: CMT interrupt
    ADC0_IRQHandler,          // 31: ADC0 interrupt
    CMP0_IRQHandler,          // 32: CMP0 interrupt
    TPM0_IRQHandler,          // 33: TPM0 single interrupt vector for all sources
    TPM1_IRQHandler,          // 34: TPM1 single interrupt vector for all sources
    TPM2_IRQHandler,          // 35: TPM2 single interrupt vector for all sources
    RTC_IRQHandler,           // 36: RTC alarm
    RTC_Seconds_IRQHandler,   // 37: RTC seconds
    PIT_IRQHandler,           // 38: PIT interrupt
    LTC0_IRQHandler,          // 39: LTC0 interrupt
    Radio_0_IRQHandler,       // 40: BTLE, ZIGBEE, ANT, GENFSK interrupt 0
    DAC0_IRQHandler,          // 41: DAC0 interrupt
    Radio_1_IRQHandler,       // 42: BTLE, ZIGBEE, ANT, GENFSK interrupt 1
    MCG_IRQHandler,           // 43: MCG interrupt
    LPTMR0_IRQHandler,        // 44: LPTMR0 interrupt
    SPI1_IRQHandler,          // 45: SPI1 single interrupt vector for all sources
    PORTA_IRQHandler,         // 46: PORTA Pin detect
    PORTB_PORTC_IRQHandler,   // 47: PORTB and PORTC Pin detect
}; /* End of g_pfnVectors */

//*****************************************************************************
// Functions to carry out the initialization of RW and BSS data sections. These
// are written as separate functions rather than being inlined within the
// ResetISR() function in order to cope with MCUs with multiple banks of
// memory.
//*****************************************************************************
__attribute__ ((section(".after_vectors.init_data")))
void data_init(unsigned int romstart, unsigned int start, unsigned int len) {
	unsigned int *pulDest = (unsigned int*) start;
	unsigned int *pulSrc = (unsigned int*) romstart;
	unsigned int loop;
	for (loop = 0; loop < len; loop = loop + 4)
		*pulDest++ = *pulSrc++;
}

__attribute__ ((section(".after_vectors.init_bss")))
void bss_init(unsigned int start, unsigned int len) {
	unsigned int *pulDest = (unsigned int*) start;
	unsigned int loop;
	for (loop = 0; loop < len; loop = loop + 4)
		*pulDest++ = 0;
}

//*****************************************************************************
// The following symbols are constructs generated by the linker, indicating
// the location of various points in the "Global Section Table". This table is
// created by the linker via the Code Red managed linker script mechanism. It
// contains the load address, execution address and length of each RW data
// section and the execution and length of each BSS (zero initialized) section.
//*****************************************************************************
extern unsigned int __data_section_table;
extern unsigned int __data_section_table_end;
extern unsigned int __bss_section_table;
extern unsigned int __bss_section_table_end;

//*****************************************************************************
// Reset entry point for your code.
// Sets up a simple runtime environment and initializes the C/C++
// library.
//*****************************************************************************
__attribute__ ((section(".after_vectors.reset")))
void Reset_Handler(void) {

    // Disable interrupts
    __asm volatile ("cpsid i");

#if defined (__USE_CMSIS)
// If __USE_CMSIS defined, then call CMSIS SystemInit code
    SystemInit();
#else
    // Disable Watchdog
    // SIM->COPC register: COPT=0,COPCLKS=0,COPW=0
    *((volatile unsigned int *)0x40048100) = 0x00u;
#endif // (__USE_CMSIS)

    //
    // Copy the data sections from flash to SRAM.
    //
	unsigned int LoadAddr, ExeAddr, SectionLen;
	unsigned int *SectionTableAddr;

	// Load base address of Global Section Table
	SectionTableAddr = &__data_section_table;

    // Copy the data sections from flash to SRAM.
	while (SectionTableAddr < &__data_section_table_end) {
		LoadAddr = *SectionTableAddr++;
		ExeAddr = *SectionTableAddr++;
		SectionLen = *SectionTableAddr++;
		data_init(LoadAddr, ExeAddr, SectionLen);
	}

	// At this point, SectionTableAddr = &__bss_section_table;
	// Zero fill the bss segment
	while (SectionTableAddr < &__bss_section_table_end) {
		ExeAddr = *SectionTableAddr++;
		SectionLen = *SectionTableAddr++;
		bss_init(ExeAddr, SectionLen);
	}

#if !defined (__USE_CMSIS)
// Assume that if __USE_CMSIS defined, then CMSIS SystemInit code
// will setup the VTOR register

    // Check to see if we are running the code from a non-zero
    // address (eg RAM, external flash), in which case we need
    // to modify the VTOR register to tell the CPU that the
    // vector table is located at a non-0x0 address.
    unsigned int * pSCB_VTOR = (unsigned int *) 0xE000ED08;
    if ((unsigned int *)g_pfnVectors!=(unsigned int *) 0x00000000) {
        *pSCB_VTOR = (unsigned int)g_pfnVectors;
    }
#endif // (__USE_CMSIS)

#if defined (__cplusplus)
    //
    // Call C++ library initialisation
    //
    __libc_init_array();
#endif

    // Reenable interrupts
    __asm volatile ("cpsie i");

	main();

	//
	// main() shouldn't return, but if it does, we'll just enter an infinite loop
	//
	while (1) {
		;
	}
}

//*****************************************************************************
// Default core exception handlers. Override the ones here by defining your own
// handler routines in your application code.
//*****************************************************************************
WEAK_AV void NMI_Handler(void)
{ while(1) {}
}

WEAK_AV void HardFault_Handler(void)
{ while(1) {}
}

WEAK_AV void SVC_Handler(void)
{ while(1) {}
}

WEAK_AV void PendSV_Handler(void)
{ while(1) {}
}

WEAK_AV void SysTick_Handler(void)
{ while(1) {}
}

//*****************************************************************************
// Processor ends up here if an unexpected interrupt occurs or a specific
// handler is not present in the application code.
//*****************************************************************************
WEAK_AV void IntDefaultHandler(void)
{ while(1) {}
}

//*****************************************************************************
// Default application exception handlers. Override the ones here by defining
// your own handler routines in your application code. These routines call
// driver exception handlers or IntDefaultHandler() if no driver exception
// handler is included.
//*****************************************************************************
WEAK_AV void DMA0_IRQHandler(void)
{   DMA0_DriverIRQHandler();
}

WEAK_AV void DMA1_IRQHandler(void)
{   DMA1_DriverIRQHandler();
}

WEAK_AV void DMA2_IRQHandler(void)
{   DMA2_DriverIRQHandler();
}

WEAK_AV void DMA3_IRQHandler(void)
{   DMA3_DriverIRQHandler();
}

WEAK_AV void Reserved20_IRQHandler(void)
{   Reserved20_DriverIRQHandler();
}

WEAK_AV void FTFA_IRQHandler(void)
{   FTFA_DriverIRQHandler();
}

WEAK_AV void LVD_LVW_DCDC_IRQHandler(void)
{   LVD_LVW_DCDC_DriverIRQHandler();
}

WEAK_AV void LLWU_IRQHandler(void)
{   LLWU_DriverIRQHandler();
}

WEAK_AV void I2C0_IRQHandler(void)
{   I2C0_DriverIRQHandler();
}

WEAK_AV void I2C1_IRQHandler(void)
{   I2C1_DriverIRQHandler();
}

WEAK_AV void SPI0_IRQHandler(void)
{   SPI0_DriverIRQHandler();
}

WEAK_AV void TSI0_IRQHandler(void)
{   TSI0_DriverIRQHandler();
}

WEAK_AV void LPUART0_IRQHandler(void)
{   LPUART0_DriverIRQHandler();
}

WEAK_AV void TRNG0_IRQHandler(void)
{   TRNG0_DriverIRQHandler();
}

WEAK_AV void CMT_IRQHandler(void)
{   CMT_DriverIRQHandler();
}

WEAK_AV void ADC0_IRQHandler(void)
{   ADC0_DriverIRQHandler();
}

WEAK_AV void CMP0_IRQHandler(void)
{   CMP0_DriverIRQHandler();
}

WEAK_AV void TPM0_IRQHandler(void)
{   TPM0_DriverIRQHandler();
}

WEAK_AV void TPM1_IRQHandler(void)
{   TPM1_DriverIRQHandler();
}

WEAK_AV void TPM2_IRQHandler(void)
{   TPM2_DriverIRQHandler();
}

WEAK_AV void RTC_IRQHandler(void)
{   RTC_DriverIRQHandler();
}

WEAK_AV void RTC_Seconds_IRQHandler(void)
{   RTC_Seconds_DriverIRQHandler();
}

WEAK_AV void PIT_IRQHandler(void)
{   PIT_DriverIRQHandler();
}

WEAK_AV void LTC0_IRQHandler(void)
{   LTC0_DriverIRQHandler();
}

WEAK_AV void Radio_0_IRQHandler(void)
{   Radio_0_DriverIRQHandler();
}

WEAK_AV void DAC0_IRQHandler(void)
{   DAC0_DriverIRQHandler();
}

WEAK_AV void Radio_1_IRQHandler(void)
{   Radio_1_DriverIRQHandler();
}

WEAK_AV void MCG_IRQHandler(void)
{   MCG_DriverIRQHandler();
}

WEAK_AV void LPTMR0_IRQHandler(void)
{   LPTMR0_DriverIRQHandler();
}

WEAK_AV void SPI1_IRQHandler(void)
{   SPI1_DriverIRQHandler();
}

WEAK_AV void PORTA_IRQHandler(void)
{   PORTA_DriverIRQHandler();
}

WEAK_AV void PORTB_PORTC_IRQHandler(void)
{   PORTB_PORTC_DriverIRQHandler();
}

//*****************************************************************************

#if defined (DEBUG)
#pragma GCC pop_options
#endif // (DEBUG)
