matyas1995/home-thermosthat/firmware/tempsensor/source/tempsensor.c

/*
 * Copyright 2016-2021 NXP
 * All rights reserved.
 *
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
 * o Neither the name of NXP Semiconductor, Inc. nor the names of its
 *   contributors may be used to endorse or promote products derived from this
 *   software without specific prior written permission.
 *
 * THIS SOFTWARE IS PROVIDED BY THE COPYRIGHT HOLDERS AND CONTRIBUTORS "AS IS" AND
 * ANY EXPRESS OR IMPLIED WARRANTIES, INCLUDING, BUT NOT LIMITED TO, THE IMPLIED
 * WARRANTIES OF MERCHANTABILITY AND FITNESS FOR A PARTICULAR PURPOSE ARE
 * DISCLAIMED. IN NO EVENT SHALL THE COPYRIGHT HOLDER OR CONTRIBUTORS BE LIABLE FOR
 * ANY DIRECT, INDIRECT, INCIDENTAL, SPECIAL, EXEMPLARY, OR CONSEQUENTIAL DAMAGES
 * (INCLUDING, BUT NOT LIMITED TO, PROCUREMENT OF SUBSTITUTE GOODS OR SERVICES;
 * LOSS OF USE, DATA, OR PROFITS; OR BUSINESS INTERRUPTION) HOWEVER CAUSED AND ON
 * ANY THEORY OF LIABILITY, WHETHER IN CONTRACT, STRICT LIABILITY, OR TORT
 * (INCLUDING NEGLIGENCE OR OTHERWISE) ARISING IN ANY WAY OUT OF THE USE OF THIS
 * SOFTWARE, EVEN IF ADVISED OF THE POSSIBILITY OF SUCH DAMAGE.
 */

/**
 * @file    tempsensor.c
 * @brief   Application entry point.
 */
#include <stdio.h>
#include "board.h"
#include "peripherals.h"
#include "pin_mux.h"
#include "clock_config.h"
#include "MKW41Z4.h"
/* TODO: insert other include files here. */
#include "FreeRTOS.h"
#include "semphr.h"
#include "task.h"
#include "fsl_clock.h"
#include "fsl_dcdc.h"
#include "fsl_gpio.h"
#include "fsl_common.h"
#include "driver_adc.h"
#include "fsl_i2c.h"
#include "fsl_i2c_freertos.h"
#include "mcp9844.h"

void vExternalTempMonitor(void *pvParameters);
void vBatteryMonitor(void *pvParameters);
void vInternalTempMonitor(void *pvParameters);

i2c_rtos_handle_t peripheral_i2c_handle;



/*
 * @brief Interrupt handling routine for Port A. Prototype defined in startup_mkw41z4.c. The generic button is tied to pin PTA 18.
 */
void PORTA_IRQHandler(void) {
	if (GPIO_GetPinsInterruptFlags(GPIOA) && BOARD_INITPINS_BTN_INT_PIN_MASK) {
		GPIO_ClearPinsInterruptFlags(GPIOA, BOARD_INITPINS_BTN_INT_PIN_MASK);
		// Dummy opereation just toggles signal LED
		GPIO_TogglePinsOutput(BOARD_INITPINS_LED_RED_GPIO, BOARD_INITPINS_LED_RED_GPIO_PIN_MASK | BOARD_INITPINS_LED_YELLOW_GPIO_PIN_MASK);
	}
}

void LVD_LVW_DCDC_IRQHandler(void) {
	if (DCDC_GetStatusFlags(DCDC) && kDCDC_PSwitchStatus) {
		DCDC_ClearStatusFlags(DCDC, kDCDC_PSwitchInterruptStatus);
		//DCDC_DoSoftShutdown(DCDC);
		// Do something on power button press
	}
}

/*
 * @brief Interrupt handling routine for Port C, on which the Charger status signal is connected. Prototype defined in startup_mkw41z4.c.
 */
void PORTB_PORTC_IRQHandler(void) {
	/*
	 * Read battery charger signals. They are active low, so invert them
	 */
	if( GPIO_ReadPinInput(BOARD_INITPINS_CHG_RUN_GPIO, BOARD_INITPINS_CHG_RUN_PIN) ^ 0x01U ) {
		/*
		 * charge is in progress
		 */
		GPIO_WritePinOutput(BOARD_INITPINS_LED_RED_GPIO, BOARD_INITPINS_LED_RED_GPIO_PIN_MASK, 1U);
		GPIO_WritePinOutput(BOARD_INITPINS_LED_RED_GPIO, BOARD_INITPINS_LED_YELLOW_GPIO_PIN_MASK, 0U);
	}
	else if( GPIO_ReadPinInput(BOARD_INITPINS_CHG_DONE_GPIO, BOARD_INITPINS_CHG_DONE_PIN ^ 0x01U ) ) {
		/*
		 * charge is done
		 */
		GPIO_WritePinOutput(BOARD_INITPINS_LED_RED_GPIO, BOARD_INITPINS_LED_RED_GPIO_PIN_MASK, 1U);
		GPIO_WritePinOutput(BOARD_INITPINS_LED_RED_GPIO, BOARD_INITPINS_LED_YELLOW_GPIO_PIN_MASK, 1U);
	}
	else
	{
		/*
		 * not charging
		 */
		GPIO_WritePinOutput(BOARD_INITPINS_LED_RED_GPIO, BOARD_INITPINS_LED_RED_GPIO_PIN_MASK, 0U);
		GPIO_WritePinOutput(BOARD_INITPINS_LED_RED_GPIO, BOARD_INITPINS_LED_YELLOW_GPIO_PIN_MASK, 0U);
	}
	GPIO_ClearPinsInterruptFlags( GPIOC, BOARD_INITPINS_CHG_DONE_GPIO_PIN_MASK | BOARD_INITPINS_CHG_PG_GPIO_PIN_MASK | BOARD_INITPINS_CHG_RUN_GPIO_PIN_MASK );
}

/*
 * @brief   Application entry point.
 */
int main(void) {
	status_t status;
	/* Init board hardware. */
    BOARD_InitBootPins();
    BOARD_InitBootClocks();
    BOARD_InitBootPeripherals();
    EnableIRQ(PORTA_IRQn);
    EnableIRQ(PORTB_PORTC_IRQn);

    i2c_master_config_t masterConfig;
    I2C_MasterGetDefaultConfig(&masterConfig);
    status = I2C_RTOS_Init(&peripheral_i2c_handle, I2C1, &masterConfig, CLOCK_GetFreq(kCLOCK_CoreSysClk)); // I2C1 is clocked by the system clock
    if (status != kStatus_Success) {
		printf("I2C master: error during init, %d", status);
	}

    xTaskCreate(vExternalTempMonitor, "TempSensor", 500, NULL, 1, NULL);
    xTaskCreate(vBatteryMonitor, "BatteryMon", 500, NULL, 1, NULL);
    xTaskCreate(vInternalTempMonitor, "InternalTempSensor", 500, NULL, 1, NULL);

    printf("Hello World\r\nStart scheduler\r\n");

    vTaskStartScheduler();

    return 0 ;
}

void vExternalTempMonitor(void *pvParameters) {
	/*
	 * Time to wait between separate conversions. Maybe use task parameters to avoid hardcoding this?
	 */
	const TickType_t xDelay = pdMS_TO_TICKS(5000UL);

	status_t status;
	uint8_t tempVal[2];
	uint16_t temperature[2];

	/*
	 * Setup and configure I2C Tempsensor
	 *
	 * Resolution can only be changed in shutdown mode, so we do that
	 */

	tempVal[0] = MCP9844_CONFIG_SHDN_MASK >> 8;
	tempVal[1] = 0x00;

	i2c_master_transfer_t xfer;
	xfer.flags = kI2C_TransferDefaultFlag;
	xfer.slaveAddress = MCP9844_GENERIC_DEVICE_ADDR;
	xfer.subaddress = MCP9844_CONFIG_REG_ADDR;
	xfer.subaddressSize = 1;
	xfer.direction = kI2C_Write;
	xfer.data = tempVal;
	xfer.dataSize = 2;

	I2C_RTOS_Transfer(&peripheral_i2c_handle, &xfer);

	xfer.subaddress = MCP9844_RESOLUTION_REG_ADDR;
	tempVal[0] = 0x00;
	tempVal[1] = MCP9844_RESOLUTION_HEXDECA;

	I2C_RTOS_Transfer(&peripheral_i2c_handle, &xfer);

	xfer.subaddress = MCP9844_CONFIG_REG_ADDR;
	tempVal[1] = 0x00;

	I2C_RTOS_Transfer(&peripheral_i2c_handle, &xfer);

	xfer.subaddress = MCP9844_CAPABILITY_REG_ADDR;
	xfer.direction = kI2C_Read;

	I2C_RTOS_Transfer(&peripheral_i2c_handle, &xfer);
	printf("MCP9844 resolution capability: %i\r\n", (tempVal[1] & 0x18) >> 3);

	xfer.subaddress = MCP9844_TAMBIENT_REG_ADDR;

	while(true) {
		tempVal[0] = 0U;
		tempVal[1] = 0U;
		status = I2C_RTOS_Transfer(&peripheral_i2c_handle, &xfer);
		if (status != kStatus_Success) {
			printf("I2C master: error during transaction, failed to read data: %d\r\n", status);
			vTaskSuspendAll();
		}
		temperature[1] = ((tempVal[0] & 0x0F) << 4) | (tempVal[1] >> 4);
		temperature[0] = (tempVal[1] & 0x0F) * 625;
		printf("I2C temperature: %i.%i \r\n", temperature[1], temperature[0]);

		printf("Now the I2C task goes to sleep\r\n");
		vTaskDelay(xDelay);
	}
}

/*
 * @brief This is a FREE_RTOS task function to monitor the battery voltage.
 */
void vBatteryMonitor(void *pvParameters) {
	/*
	 * Time to wait between separate conversions. Maybe use task parameters to avoid hardcoding this?
	 */
	const TickType_t xDelay = pdMS_TO_TICKS(6000UL);

	while(true) {
		printf("Battery Voltage: %i mV\r\n", DRIVER_ADC_GetBatteryMv());

		printf("Now the Battery task goes to sleep\r\n");
		vTaskDelay(xDelay);
	}
}

/*
 * @brief This is a FREE_RTOS task function to monitor the chip internal temperature sensor voltage.
 */
void vInternalTempMonitor(void *pvParameters) {
	/*
	 * Time to wait between separate conversions. Maybe use task parameters to avoid hardcoding this?
	 */
	const TickType_t xDelay = pdMS_TO_TICKS(5000UL);

	while(true) {
		/*
		 * Write sensor voltage
		 */
		printf("ADC Tempsensor measurement value: %i\r\n", DRIVER_ADC_TempCelsius());

		printf("Now the Tempsensor task goes to sleep\r\n");
		vTaskDelay(xDelay);
	}
}
