matyas1995/home-thermosthat/firmware/tempsensor/source/driver_adc.c

/*
 * driver_adc.c
 *
 *  Created on: 11.04.2021
 *      Author: matyas
 */
#include "driver_adc.h"

static SemaphoreHandle_t xADCSemaphore;
static SemaphoreHandle_t xADCMutex;
static adc16_config_t adc16ConfigStruct;
static adc16_channel_config_t adc16ChannelConfigStruct;
volatile static uint32_t adc16ConversionValue = 0;

/*
 * @brief Interrupt handling routine for the ADC. Sets a binary semaphore to signalize starting thread that a conversion has been executed
 */
void ADC0_IRQHandler(void) {
	BaseType_t xHigherPriorityTaskWoken;
	adc16ConversionValue = ADC16_GetChannelConversionValue(ADC0, 0U); // dummy read to clear the interrupt
	xSemaphoreGiveFromISR(xADCSemaphore, &xHigherPriorityTaskWoken);
	portYIELD_FROM_ISR(xHigherPriorityTaskWoken);
}

void DRIVER_ADC_Init(void) {
	/*
	 * Set up a binary semaphore and mutex for accessing the ADC hardware.
	 * The binary semaphore is used by the ADC's ISR to signal the end of a conversion
	 */
	xADCSemaphore = xSemaphoreCreateBinary();
	xADCMutex = xSemaphoreCreateMutex();

	vref_config_t vrefConfigStruct;
	VREF_GetDefaultConfig(&vrefConfigStruct);
	VREF_Init(VREF, &vrefConfigStruct);

	EnableIRQ(ADC0_IRQn);

	/*
	 * adc16ConfigStruct.referenceVoltageSource = kADC16_ReferenceVoltageSourceVref;
	 * adc16ConfigStruct.clockSource = kADC16_ClockSourceAsynchronousClock;
	 * adc16ConfigStruct.enableAsynchronousClock = true;
	 * adc16ConfigStruct.clockDivider = kADC16_ClockDivider8;
	 * adc16ConfigStruct.resolution = kADC16_ResolutionSE12Bit;
	 * adc16ConfigStruct.longSampleMode = kADC16_LongSampleDisabled;
	 * adc16ConfigStruct.enableHighSpeed = false;
	 * adc16ConfigStruct.enableLowPower = false;
	 * adc16ConfigStruct.enableContinuousConversion = false;
	 */
	ADC16_GetDefaultConfig(&adc16ConfigStruct);

	/*
	 * Enable ADC and calibrate
	 */
	ADC16_Init(ADC0, &adc16ConfigStruct);
	ADC16_DoAutoCalibration(ADC0);
	ADC16_EnableHardwareTrigger(ADC0, false);

	ADC16_SetHardwareAverage(ADC0 , kADC16_HardwareAverageCount16);
}

void DRIVER_ADC_Deinit(void) {
	/*
	 * Finally, deinit the VREF and the ADC to save some power
	 */
	VREF_Deinit(VREF);
	ADC16_Deinit(ADC0);
	DisableIRQ(ADC0_IRQn);
}

/*
 * Measure and return a voltage on the specified ADC channel
 * Measurement in single ended mode
 */
static uint32_t DRIVER_ADC_Read(uint32_t xChannelId) {
	/*
	 * Configure the ADC channel
	 * Channel 23 corresponds to scaled battery voltage
	 * Enable the interrupt generation on completion
	 * Single ended conversion
	 */
	adc16ChannelConfigStruct.channelNumber = xChannelId;
	adc16ChannelConfigStruct.enableInterruptOnConversionCompleted = true;
	adc16ChannelConfigStruct.enableDifferentialConversion = false;

	/*
	 * Configure ADC channel group 0
	 * A write will immediately start the conversion
	 * Then block on the binary semaphore for the Interrupt handler to signal completion and data read
	 * Mutex ensures no two processes may initiate a conversion at the same time
	 */
	xSemaphoreTake(xADCMutex, portMAX_DELAY);
	ADC16_SetChannelConfig(ADC0, 0U, &adc16ChannelConfigStruct);
	xSemaphoreTake(xADCSemaphore, portMAX_DELAY); // Indefinite timeouts not recommended for production code ;)
	xSemaphoreGive(xADCMutex);
	return adc16ConversionValue;
}

/*
 * @brief Gets the current voltage of the battery
 *
 * This function measure the ADC channel corresponding to the battery
 */
uint32_t DRIVER_ADC_GetBatteryMv(void) {
	/*
	 * Normally, one would calculate
	 * DRIVER_ADC_Read(ADC16_BATLVL_CHN) * 4 / 4095 * VREF_VOLTAGE
	 * for scaling the /4 input scaling of the battery voltage input and to normalize it first to the 12 bit measurement resolution of the ADC
	 * and then to the 1195mV of the ADC reference voltage
	 * As the ADC range is 12 bit (max value 4095), the battery voltage scaling and normalizing can be combined together from VALUE * 4 / 4095 to just VALUE / 1023
	 */
	return DRIVER_ADC_Read(ADC16_BATLVL_CHN) * VREF_VOLTAGE / 1023; /* The Battery Voltage is divided by 4 before being fed into ADC, which is using the fixed 1195mV reference source */
}

/*
 * @brief Gets the raw tempsensor reading
 */
uint32_t DRIVER_ADC_TempRaw(void) {
	return DRIVER_ADC_Read(ADC16_TEMP_SENSOR_CHN);
}

/*
 * @brief Gets the temperature sensor reading in degrees Celsius
 */
uint32_t DRIVER_ADC_TempCelsius(void) {
	/*
	 * Temperature in degrees celsius is calculated with the formula
	 * 25 - ((V_temp - V_temp25) / Tempsensor_slope)
	 *
	 * The following function calculates the temperature in micro Celsius to avoid calculating with floating point values while retaining adequate accuracy.
	 * This is done because the Cortex m0+ core lacks an FPU, making floating point calculations very slow
	 */
	return 25000000 - ((DRIVER_ADC_Read(ADC16_TEMP_SENSOR_CHN) * VREF_VOLTAGE * 1000 / 4095 - TEMPSENSOR_VTEMP25) / TEMPSENSOR_SLOPE);
}
