matyas1995/home-thermosthat/(commit log)

2020-02-29 Started work on thermostat, power converters and buttons still missing from schematic.
    [USB_UART.sch, display_connector.sch, home-thermostat.kicad_pcb, home-thermostat.sch]
2020-03-03 Added power supply and thermosthat control circuitry.
    [USB_UART.sch, display_connector.sch, home-thermostat.sch, power_supply.sch, regulator_out.sch]
2020-03-03 Added RTC for timekeeping, AVR can now measure supply voltage.
    [home-thermostat.sch, power_supply.sch, regulator_out.sch]
2020-03-03 Changed usb port to ISP programming as CP2102 IC is not available from Reichelt.
    [display_connector.sch, home-thermostat.sch, power_supply.sch, regulator_out.sch]
2020-03-03 Added Temperature sensor.
    [display_connector.sch, home-thermostat.sch, power_supply.sch, regulator_out.sch]
2020-03-03 Initial draft of thermostat done, beautified circuit diagram.
    [home-thermostat.sch, regulator_out.sch]
2020-03-04 Exchanged 3,3V LDO with one I found at home.
    [home-thermostat.sch]
2020-03-05 Exchanged AVR crystal with one I already have.
    [home-thermostat.sch, regulator_out.sch]
2020-03-05 Started adding footprints.
    [home-thermostat.sch, regulator_out.sch]
2020-03-05 Added footprints to most symbols.
    [home-thermostat.sch, regulator_out.sch]
2020-03-05 Added all footprints except for ones which I have to look up in the E-Lab.
    [home-thermostat.sch, regulator_out.sch]
2020-03-13 Moved project files for thermostat into subdirectory to make space for the other hardware files.
    [USB_UART.sch, display_connector.sch, home-thermostat.kicad_pcb, home-thermostat.sch, power_supply.sch, regulator_out.sch]
2020-03-13 Created first rough draft of the temperature sensors.
    [home-thermostat.sch, tempsensor.kicad_pcb, tempsensor.sch]
2020-03-13 Added testpads to tempsensor, added missing TWI lines to EEPROM.
    [home-thermostat.sch, tempsensor.sch]
2020-03-13 Removed OP-AMP from tempsensor, not really needed.
    [tempsensor.sch]
2020-03-18 Changed Tempsensor power-on circuit to use the enable pin of the step-down converter. Added some footprints.
    [tempsensor.sch]
2020-03-19 Added remaining footprints to thermosthat, redesigned self-turn-off circuit of tempsensor.
    [home-thermostat.sch, regulator_out.sch, tempsensor.sch]
2020-03-19 Started working on thermosthat PCB, just assorting footprints by function group.
    [home-thermostat.sch, regulator_out.sch]
2020-03-27 Started layouting thermosthat.
    [home-thermostat.kicad_pcb, home-thermostat.sch]
2020-03-27 Advanced component placement, laid out some routes.
    [home-thermostat.kicad_pcb]
2020-03-28 Finished first PCB circuit draft. May not be optimal at all, regarding EMI etc.
    [home-thermostat.kicad_pcb, regulator_out.sch]
2020-03-29 Finished layout of Thermosthat.
    [home-thermostat.kicad_pcb]
2020-03-29 Added interrupt circuit to tempsensor MCP9844 to allow it to wake up ESP on temperature changes (so that I can program thresholds instead of waking up more often).
    [tempsensor.sch]
2020-03-29 Added some footprints to tempsensor.
    [tempsensor.sch]
2020-03-30 Tempsensor finished adding footprints
    [tempsensor.sch]
2020-03-30 Created 4x4cm PCB for tempsensor, first routing done.
    [tempsensor.sch]
2020-04-02 Finished layouting, exchanged two false diode packages, added protection diode to RTC reset line output, updated config button circuit.
    [tempsensor.kicad_pcb, tempsensor.sch]
2020-07-29 Removed ESP from schematic, will switch over to NXP MKW41Z as it has better documentation, easier peripherals and support for low power thread protocol instead of WLAN to save energy in battery backe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
    [home-thermostat.sch]
2020-08-08 Moved eINK display circuit into its own schematic to abstract control signals. Added a document about touch sensing. Touch should not be implemented on this revision.
    [display.sch, home-thermostat.sch, regulator_out.sch]
2020-08-08 Moved RTC chip and temperature sensor to separate schematic for better organisation. No interrupt from RTC chip is used as the MKW41Z has its own RTC with interrupt function and only needs the RTC ch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
    [display.sch, home-thermostat.sch, regulator_out.sch, sensors.sch]
2020-08-08 Added MKW41Z to schematic, start doing the base connections.
    [home-thermostat.sch]
2020-08-10 Finished minimal connections for MKW41Z (I hope), added design files for FRDM development board to look up antenna connections etc.
    [BOM-29102_C2.xlsx, home-thermostat.sch]
2020-08-10 Added manual reset button to schematic. Might come handy sometime.
    [home-thermostat.sch, regulator_out.sch]
2020-08-10 Removed 0Ohm capacitor from 32,768KHz crystal as it was only for bypassing crystal in evalboard if the MCU pin is used otherwise.
    [home-thermostat.sch]
2020-08-10 Added some helpful comments to schematic, added explanation document to schematic of evalboard.
    [home-thermostat.sch]
2020-08-11 Added some comments to pin usage on MKW41Z, reconfigured display to use 3 line SPI (no Data/Command pin) with 9 bit data packets
    [display.sch, home-thermostat.sch]
2020-08-11 Connected display SPI to MKW41Z
    [home-thermostat.sch]
2020-08-11 Added some descriptions and the possibility to use VDD as reference voltage for the ADC of the MKW41Z. This can come handy if we want to use the ADC to measure voltages.
    [home-thermostat.sch, regulator_out.sch]
2020-08-11 Deleted ATMega from schematics because I will only use the MKW41Z for everything.
    [regulator_out.sch]
2020-08-11 Moved I2C peripherals into one schematic, moved GPIO peripherals onto main schematic.
    [display.sch, home-thermostat.sch, regulator_out.sch, sensors.sch]
2020-08-16 Put LEDs and GPIOs into separate schematic, GPIO for arrow buttons are now attached over an expander.
    [display.sch, gpio.sch, home-thermostat.sch, regulator_out.sch, sensors.sch]
2020-09-20 Fixed orphaned symbols after Kicad library update. Kinetis MCU is now in upstream, thanks to me :)
    [home-thermostat.sch, regulator_out.sch, sensors.sch]
2020-09-20 Updated symbols after library update, some footprints still need to be assigned. Deleted PCB except for Display and buttons. Button arrangement wrong. Move buttons to other side of Display. Maybe put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
    [display.sch, gpio.sch, home-thermostat.kicad_pcb, home-thermostat.sch, regulator_out.sch, sensors.sch]
2020-09-25 Finalized Thermostat circuit based on the MKW41Z.
    [gpio.sch, home-thermostat.kicad_pcb, home-thermostat.sch, regulator_out.sch, sensors.sch]
2020-09-25 Added testpad to supply rail +5V to allow flexible powering of board,also over Arduino.
    [home-thermostat.sch]
2020-09-26 Started grouping footprints on PCB, configured minimal via and trace sizes for PCB_POOL.
    [home-thermostat.kicad_pcb, home-thermostat.sch, regulator_out.sch]
2020-09-26 Started routing some subgroups, going to put GPIO on other board and not attach display directly, as that would make the PCB too large and expensive.
    [home-thermostat.kicad_pcb]
2020-09-28 Removed buttons and signal LEDs as they should be moved to a separate peripheral board (to save expensive board space on the 4-layer PCB). Added bus transceiver for UART_RX to optionally be able to a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
    [gpio.sch, home-thermostat.sch]
2020-09-28 Fine grouping of parts done, may start routing . GPIO connector on wrong side of PCB (I wanted to have the buttons on the opposite side, but thats not a big problem.
    [gpio.sch, home-thermostat.kicad_pcb, home-thermostat.sch, regulator_out.sch, sensors.sch]
2020-09-29 Changed LED and regulator_out drivers to NMOS instead of bipolar. Started routing, SPI and I2C lines done.
    [gpio.sch, home-thermostat.kicad_pcb, home-thermostat.sch, regulator_out.sch]
2020-10-01 Modivied DRC constraints according to specs of PCB_POOL, finished layouting signal lines, only power is left.
    [home-thermostat.kicad_pcb, home-thermostat.sch, regulator_out.sch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]
2020-10-05 Finished routing except for the RF line, still need to add many many grounding vias.
    [home-thermostat.kicad_pcb, sensors.sch]
2020-10-05 Modified copper pours to keep required 0,3mm distance from board edges, added 50Ohm trace for RF line, still need to add GND vias and pin1 markings.
    [home-thermostat.kicad_pcb]
2020-10-10 Created GND plane stitching with helper script, added markings to pin headers, solder jumpers and pin1 of footprints. Ready for manufacturing.
    [home-thermostat.kicad_pcb]
2020-10-10 Changed footprint of MKW41Z to one with individual center GND pads and no thermal vias so that I am able to set own via sizes for the thermals.
    [home-thermostat.kicad_pcb, home-thermostat.sch]
2020-10-13 Replaced DCDC input cap as the package was way too small for the required capacitance, started working on the BOM and looking up parts on Mouser. Need to replace input Molex connector as it is not in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
    [display.sch, home-thermostat.csv, home-thermostat.kicad_pcb, regulator_out.sch, sensors.sch]
2020-10-15 Replaced Molex PicoBlade SMT connector with THT version as this is available at Mouser. This also helps since the pins act as vias. Resolved DRC errors, Antenna trace needs to be set then we are read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
    [home-thermostat.csv, home-thermostat.kicad_pcb, home-thermostat.sch, regulator_out.sch]
2020-10-26 Changed Button lines to MKW41 pins that also have LLWU interrupt capabilities. It will never get there, but who knows what the future brings.
    [home-thermostat.kicad_pcb, home-thermostat.sch, regulator_out.sch, sensors.sch]
2020-10-26 Created base schematic for MKW41 tempsensor, still need to finetune it.
    [tempsensor.kicad_pcb, tempsensor.sch]
2020-11-03 Finished Tempsensor schematic based on MKW41Z. Many footprints not associated yet.
    [I2C.sch, MKW41_PERIPHERAL_PWR.sch, tempsensor.sch]
2020-11-03 Added footprints to tempsensor.
    [I2C.sch, MKW41_PERIPHERAL_PWR.sch, tempsensor.kicad_pcb, tempsensor.sch]
2020-11-16 Started layouting the TempSensor, exchanged the large LEDs for 0603 LEDs (from ELAB). MCU needs to be placed. Changed signals on expansion header to put power pins onto just one end.
    [I2C.sch, MKW41_PERIPHERAL_PWR.sch, tempsensor.kicad_pcb, tempsensor.sch]
2020-11-21 Continued routing of tempsensor, basic functionality done.
    [I2C.sch, MKW41_PERIPHERAL_PWR.sch, tempsensor.kicad_pcb, tempsensor.sch]
2020-12-08 Finished layouting tempsensor and thermostat. Parts are ordered from Mouser, PCB ordered from beta-layout.
    [MKW41_PERIPHERAL_PWR.sch, Mouser_BOM.xls, home-thermostat.csv, home-thermostat.kicad_pcb, regulator_out.sch, sensors.sch, tempsensor.csv, tempsensor.kicad_pcb]
2020-12-13 Specified some resistor values.
    [gpio.sch]
2020-12-23 Changed UART level shifter package on thermosthat, however there is not enough space on tempsensor.
    [home-thermostat.kicad_pcb, home-thermostat.sch]
2021-04-07 Extended skeleton project with a basic board initialization and a basic task that periodically reads the battery voltage.
2021-04-18 Continued work on ADC implementation. Battery voltage can be read out, temperature sensor needs to be calibrated by me as the example projects are unusable.
2021-04-18 Created register makros for MCP9844 registers. Started developing RTOS peripheral drivers as their own tasks that communicate over queues. This may not be perfect as using mutexes would allow for pri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
2021-05-02 Changed ADC driver back to use functions and mutexes. No RTOS task apart from main may call init and deinit function.
2021-05-02 Created little task to initialize I2C and to read out the tempsensor(s). Utterly needs calibration.
2021-05-16 Moved part names and values back from fab layer to silkscreen layer. Otherwise, printing placement plans is very confusing.
    [home-thermostat.kicad_pcb]
2021-06-02 Resolved merge conflicts upon retrieving stashed stuff.
    [tempsensor.c]
2021-06-10 Configured MCU pins (without interrupts).
2021-06-10 Removed pulldown resistor on regulator out pin of MCU. This pin is default non-maskable interrupt pin. On reset, this pulldown resistor immediately triggered the NMI interrupt, sabotaging the startup.
    [home-thermostat.kicad_pcb, regulator_out.sch]
2021-10-29 Copied sources over from OpenThread official port back to MCUXpresso IDE. Will not compile straigt away and need to change bits relating to FRDM evalboard (NMI handler etc.). Also not sure how and if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
2021-12-17 Added openthread sources as a git submodule. Copied radio related stuff from SDK. Copied kw41z openthread port into firmware directory, not as a subproject as I will modify it to fit better to MCUXpr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
2022-01-14 Added sources, includes and defines to C++ compiler, included remaining fsl drivers so that compilation now runs without errors. The linker still throws major hassle as the image is 20 percent bigger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
    [uart.c]
2022-01-16 Turned on compile optimization and link against NewLib(Nano) with nohost option. This actually yields a result that fits into device flash. Not testet for functionality though.
2022-01-30 Managed to integrate openthread and kw41z port into MCUEclipse so that there are no compilation errors or warnings. System init fails to complete though due to CAlloc of openthread failing to allocat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
    [system.c]
2022-02-10 Openthread finally compiles and initializes with FreeRTOS. However, the interrupt on console inputs does not correctly trigger and wake the OpenThread task.
    [openthread-freertos.h, openthread_freertos.c, thermosthat.c, uart.c, uart_lock.c, uart_lock.h]
2022-02-13 OpenThread finally starts with FreeRTOS. OpenThread process not interrupt driven (yet). UART will need to get its own process for that. Did not try to create wireless network yet, only CLI app seems 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
2022-02-21 Changed openthread port config file to define uart lock header as a file instead of a fixed include (that way it was included everywhere).
    [openthread-core-kw41z-config.h]
2022-02-22 Added missing dependencies to XCVR driver. Removed toolchain setting from CMakeLists.txt as this is a mandatory command line argument.
2022-02-25 Moving forward to compile project with Cmake. Discovered that Openthread did not use the FreeRTOS memory calloc functions (I thought I implemented that one already...). So that still needs to be done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
2022-03-07 Added trace config to FreeRTOS, added option to exclude stdlib to linker options
2022-03-10 Renamed thermosthat firmware file with .elf ending to make its purpose more clear. Also added the --print-memory-usage linker flag to output the binary stats after building. Its important to know if 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
2022-03-13 Added todo notice in openthread task sourcecode as a reminder. Removed printf commands from thermosthat.c (well, just commented them out).
2022-03-13 Added assembler init code as this maybe does better than the crappy c code. Compile does not work as Cmake somewhere adds a -x c flag, forcing the assembler file to go through GCC as if it was C. Som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
2022-08-11 Extended todo and readme for more clarity, added build script to easily start builds from the console. Build script directs make to use 16 threads.
2022-08-12 Created little script to automatically send patch emails to me, in case I am developing somewhere without access to my gitserver and am not on the laptop to carry home for a git push
2022-08-12 Modified patch emailer script to automatically email all new commits on the current branch since the origin/BRANCH state.
2022-08-28 Finished porting to CMAKE and KDevelop. MCU is able to boot and to initialize the memory. FreeRTOS Heap integration with linker script (the correct placement in memory) and size configuration over CM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
    [thermosthat.c]
2022-08-30 Check in work on bringing up the OpenThread interface. Board runs but no reactions over UART can be observed.
